Chinglyn/SDP-2A/README.md

# SDP-2A电控板
PCB板号CLR.DB01.A
PCBA料号：21.03.01.27.00
功能：DS18B20检测温度、电机控制出片、加热器吹风控制等
