Chinglyn/SDP-2A/15 电控设计方案书/SDP-2A电控设计框图.docx

SDP-2A相关框图

1、 功能框图

功能框图主要说明SDP-2A包含哪些功能模块，以及相关功能模块之间的关系。

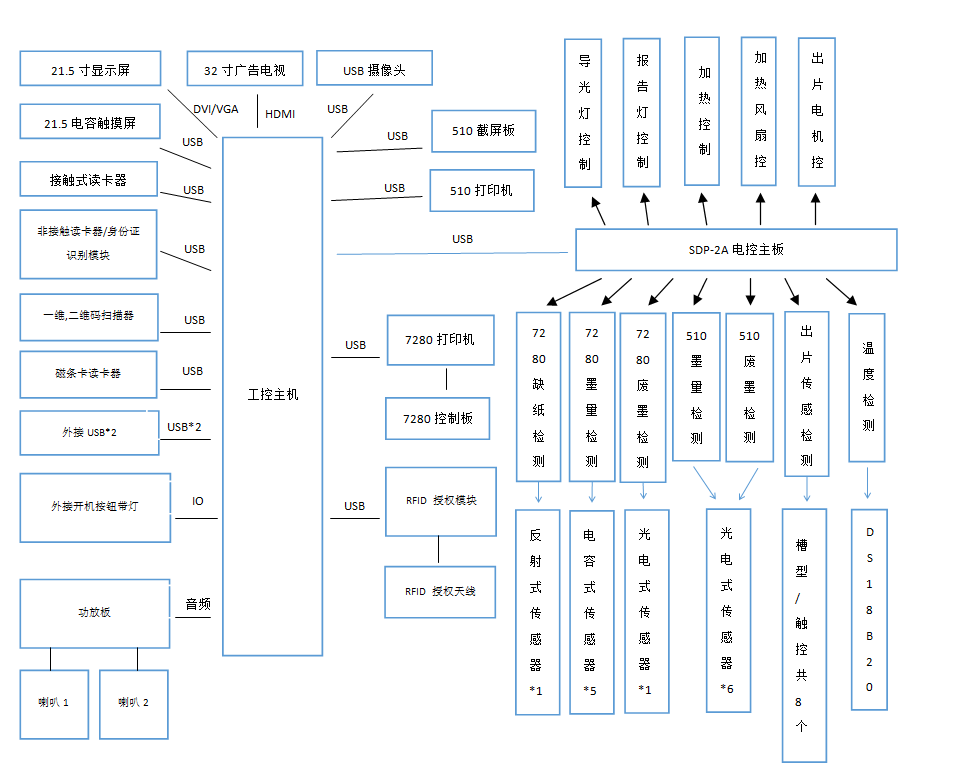
[picture p17: figure]
SDP-2A功能框图

2、 电气框图

电气框图主要说明SDP-2A 电气相关走向。

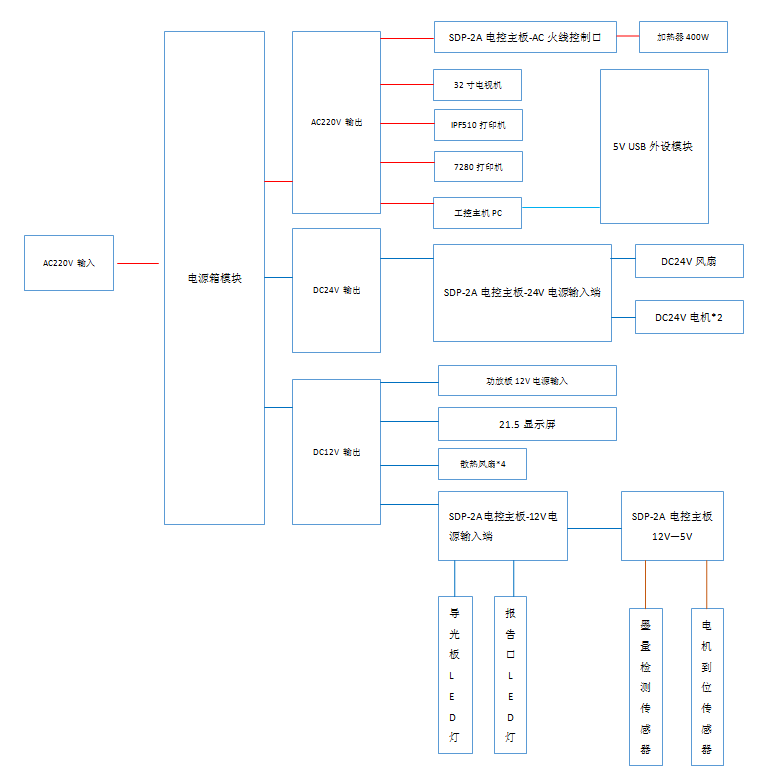
[picture p18: figure]
SDP-2A 电气结构框图
