Chinglyn/SDP-2A/10 BOM清单/CLR.DB01.A_BOM_V1.1_20171115.xlsx

Sheet: 变更
变更描述： 1. CLR.DB03.A, kb A级，尺寸:55*55(mm),板厚1.6mm,FR4，双面板,无铅,蓝油，沉金 描述错误，更改为CLR.DB01.A, kb A级，尺寸:140*110(mm),板厚1.6mm,FR4，双面板,无铅,蓝油，沉金
日期 | 2017-11-15

Sheet: BOM表
序号 | 物料编码 | 图纸番号 | 版本号 | 名称 | 规格参数 | 封装 | 数量 | 单位 | 位号 | 工艺 | 替代型号 | 注释 | 指定供应厂商（代理） | 联系人 | 联系方式
1 |  |  |  | PCB | CLR.DB01.A, kb A级，尺寸:140*110(mm),板厚1.6mm,FR4，双面板,无铅,蓝油，沉金 | / | 1 | PCS
2 |  |  |  | 贴片电容 | X5R,0.1uF±10%,50V,0805 | 0805 | 35 | PCS | C1,C6,C7 C9,C10,C11,C13,C14 C16,C17,C18,C19,C20,C21,C22,C23,C25,C27,C28,C29,C30,C31,C32,C33,C44,C46,C48,C52 C55,C57,C61,C62,C63,C82,C90 | SMT |  | 0.1uF=100nF
3 |  |  |  | 贴片电容 | X5R,1000pF±10%,50V,0805 | 0805 | 7 | PCS | C37,C38,C39,C40,C41,C42,C93 | SMT |  | 1000pF=1nF
4 |  |  |  | 贴片电容 | X5R,10uF±10%,50V,0805 | 0805 | 9 | PCS | C8,C12,C15,C24,C26,C51,C56,C58,C85 | SMT
5 |  |  |  | 贴片电容 | X5R,22pF±10%,16V,0805 | 0805 | 4 | PCS | C4,C5,C43,C45 | SMT
6 |  |  |  | 贴片电容 | X5R,10uF±10%,16V,0805 | 0805 | 3 | PCS | C35,C36,C49 | SMT
7 |  |  |  | 贴片二极管 | 1N5819,DO-214AC | DO-214AC | 8 | PCS | D2,D3,D4,D5,D6,D8,D10,D12 | SMT
8 |  |  |  | 贴片功率电感 | GDH74–6R8N 6.8uH | INDB700X700N | 1 | PCS | L4 | SMT
9 |  |  |  | 贴片LED | 贴片LED SMD 型号：1206-1-BC VF:1.9-2.1V 蓝色 | 0805 | 4 | PCS | D1,D7,D9,D11 | SMT
10 |  |  |  | 贴片共模电感 | ACM2012-900-2P,0805 | 0805 | 1 | PCS | FB8 | SMT
11 |  |  |  | 贴片MOS管 | 贴片MOS管,IRF540S,N沟道MOS管,SOT404 (D2PAK) | SOT404 | 1 | PCS | Q3 | SMT
12 |  |  |  | 贴片MOS管 | BLM3400,N沟道MOSFET,Vds=30V,Id=5.8A,SOT23 | SOT23 | 5 | PCS | Q1,Q2,Q4,Q5,Q6 | SMT | AO3400A
13 |  |  |  | 贴片光耦 | TLP181GB,SOP4 | SOP4 | 2 | PCS | U2,U3 | SMT
14 |  |  |  | 贴片电阻 | 100K±5%,1/8W,0805 | 0805 | 2 | PCS | R121,R132 | SMT
15 |  |  |  | 贴片电阻 | 2K±5%,1/8W,0805 | 0805 | 9 | PCS | R3,R6,R15,R59,R64,R72,R76,R97,R113 | SMT
16 |  |  |  | 贴片电阻 | 44.2K±1%,1/8W,0805 | 0805 | 1 | PCS | R124 | SMT
17 |  |  |  | 贴片电阻 | 0R±5%,1/8W,0805 | 0805 | 23 | PCS | R7,R10,R16,R19,R36,R54,R57,R58,R60,R65,R68 R77,R78,R85,R89,R93,R98,R99,R114,R128,R129，R130,R131 | SMT
18 |  |  |  | 贴片电阻 | 0.3Ω±1%,1W,2512 | 2512 | 2 | PCS | R24,R25 | SMT
19 |  |  |  | 贴片电阻 | 10K±5%,1/8W,0805 | 0805 | 15 | PCS | R26，R31,R33,R34,R53,R56,R67,R71,R75,R84,R87,R88 ,R91,R100,R123 | SMT
20 |  |  |  | 贴片电阻 | 1K±5%,1/8W,0805 | 0805 | 29 | PCS | R4,R11,R12,R18, R21，R23,R29,R39,R43,R47,R51,R55,R62,R70,R74,R81,R82,R83,R86,R90,R95,R101,R105,R109,R111,R116,R117,R119,R120 | SMT
21 |  |  |  | 贴片电阻 | 200Ω±5%,1/8W,0805 | 0805 | 2 | PCS | R35，R28 | SMT
22 |  |  |  | 贴片电阻 | 300Ω±5%,1/8W,0805 | 0805 | 8 | PCS | R22,R30,R40,R44,R48,R52,R102,R106 | SMT
23 |  |  |  | 贴片电阻 | 390Ω±5%,1/8W,0805 | 0805 | 9 | PCS | R2,R5,R13,R20,R63,R69,R73,R96,R112 | SMT
24 |  |  |  | 贴片电阻 | 4.7K±5%,1/8W,0805 | 0805 | 14 | PCS | R1,R9,R14,R32,R37,R41,R45,R49,R79, R103,R107,R118,R122 | SMT
25 | 21.04.000200 |  |  | 贴片IC | A4954ELP-T,TSSOP16 | TSSOP16 | 1 | PCS | U7 | SMT |  |  | 由柯丽尔提供
26 | 21.04.001000 |  |  | 贴片IC | STC15W4K32S4,LQFP48 | LQFP48 | 1 | PCS | U5 | SMT |  | 需烧录固件 | 由柯丽尔提供
27 | 21.04.000400 |  |  | 贴片IC | CH340G,SOP16 | SOP16 | 1 | PCS | U11 | SMT |  |  | 由柯丽尔提供
28 | 21.04.001100 |  |  | 贴片IC | ZTP7193SI,SOP8 | SOP8 | 1 | PCS | U10 | SMT |  |  | 由柯丽尔提供
29 |  |  |  | 贴片ESD | WE05R,SOT143 | SOT143 | 1 | PCS | U6 | SMT
30 |  |  |  | 贴片晶振 | 11.0592MHz,±20PPM,CL=22pF,HC-49SMD | HC-49SMD | 1 | PCS | Y1 | SMT
31 |  |  |  | 贴片晶振 | 12MHz,±20PPM,CL=22pF,HC-49SMD | HC-49SMD | 1 | PCS | Y2 | SMT
32 |  |  |  | XH连接器 | XH 2.54mm-4P 电流 6A 直插 | XH2.54_4P | 1 | PCS | J34 | DIP
33 |  |  |  | 直插电解电容 | 220uF±20%,50V,10mm*12mm | 10mm*12mm | 2 | PCS | C47,C81 | DIP
34 |  |  |  | 直插电解电容 | 470uF±20%,10V,6mm*12mm | CE/8MM | 2 | PCS | C2,C34 | DIP
35 |  |  |  | 插件蜂鸣器 | 5V,有源电磁式,直径12mm*高9.5mm,引脚间距7.6mm | BEEP | 1 | PCS | BEEP | DIP
36 |  |  |  | AMP连接器 | AMP-292132-3,2.0mm-3P | PH-3P-2.0 | 7 | PCS | J17,J18,J19,J20,J21,J22 J27 | DIP
37 |  |  |  | PH连接器 | PH2.0mm-3P | PH-3P-2.0 | 8 | PCS | J1,J5 J7,J8,J9,J11,J29,J33 | DIP
38 |  |  |  | CH连接器 | CH3.96mm-2P | CH3.96_2P_2 | 2 | PCS | J23,J25 | DIP
39 |  |  |  | 绿色边沿连接器 | Edg 5.08mm-2P-90 90度 | SIP-2-5.08 | 1 | PCS | J24 | DIP
40 |  |  |  | VH连接器 | VH 3.96mm-2P 带扣 直插 | CH_3.96-2P | 1 | PCS | J32 | DIP
41 |  |  |  | XH连接器 | XH 2.54mm-2P 电流 6A 直插 | XH-2.54-2P | 3 | PCS | J26,J30,J31 | DIP
42 |  |  |  | 排针 | 2.54mm，2P，9mm高 | SIP-2P | 1 | PCS | J28 | DIP
43 |  |  |  | 跳线帽 | 2.54mm,2P | / | 1 | PCS | J28 | DIP |  | 插在排针上
44 |  |  |  | PH连接器 | PH 2.0mm-5p 直插 | PH-5P-2.0 | 1 | PCS | J3 | DIP
45 |  |  |  | XH连接器 | XH 2.54mm-3P 直插 | XH-2.54-3P | 7 | PCS | J4,J10,J12,J13,J14,J15,J16 | DIP
46 |  |  |  | / | NC | / | 20 | PCS | D13,Q7,R8,R17,R27,R38,R42,R46,R50,R61,R66,R80,R92,R94 ,R104,R108,R110,R115,R126,R127 |  |  | 不贴
