Chinglyn/SDP-2A/04 PCB制作表/PCB制作表CLR.DB01.A.xls

深圳市巨鼎医疗设备有限公司
CLR.DB01.A加工工艺要求
 |  |  |  |  | 填表日期：2016 年11月18日
厂商资料 | 1.厂商名称 |  |  | 5.E-mail/FTP
 | 2.联系人 |  |  | 6.厂商料号
 | 3.TEL |  |  | 7.预计完成日
 | 4.FAX |  |  | 8.交货数量
资料内容 | 1.档案名称 | CLR.DB07.A gerber.rar
 | 2.料号
 | 3.版本号 | V1.0
 | 4.档案格式 | ■ GERBER □ PCB □其他
 | 5.书面资料 | □ 无 ■ 有
 | 6.线路层 | □ 无 ■ 有
 | 7.孔径孔位图 | □ 无 ■ 有
 | 8.阻焊层 | □ 无 ■ 有
 | 9.丝印层 | □ 无 ■ 有
 | 10.机械图 | □ 无 ■ 有
 | 11.拼板方式 | 无
制作要求 | 1.基板材料 | ■ FR4 □ CEM □ 其他
 | 2.阻燃级别 | ■ 94V0 □ 其他
 | 3.铜箔厚度 | □ 1/2OZ ■ 1OZ □ 1.5OZ □ 2OZ □ 其他:
 | 4.钻孔方式 | ■ 机械钻 □ 激光钻
 | 5.最大尺寸 | 单板 110mm*140mm
 | 6.成品厚度 | □ 1.0mm □ 1.2mm ■ 1.6mm □ 2.0mm □ 其他
 | 7.基板层数 | ■ 2L □ 4L □ 6 □ 8L □ 其他
 | 8.表面处理 | ■ 化学沉金 □ 全板镀金 □ 化学浸镍 □ 其他:BGA OSP
 | 9.阻焊 | □ 单面 ■ 双面 ■ 其他:蓝油
 | 10.丝印 | □ 单面 ■ 双面 ■ 其他:白油
 |  | UL Logo: | □ 有 ■ 无 | 加于 层
 | 11.外型加工 | □ 模具冲 □ 铣 ■ V-CUT
 |  |  | V-CUT规格：角度 | 深度 | 残厚
 | 12.埋盲孔 | 层 至 层 层至 层 层至 层 层至 层
 | 13.塞孔 | ■ 是 □ 否 (需要赛孔)
 | 14.特性阻抗 | 层，线宽 ，规格 ±Ω，其他：
 | 15. 其他 | 在能满足正常贴焊要求的前提下，PCB所含镍的成分越少越好！
备注 | 以上如果有疑问，请进行书面确认。
 | 工程问题联系人： |  | 张斌 | Email： | zhangbin@rdcofclear.com
 | 电话： |  | 13427559902
