Chinglyn/SDP-2A/08 PCBA板接口说明/SDP-2A CLR.DB01.A 电控装机说明.xls

SDP-2A 电控板CLR.DB01.A 接口说明
序号 | 名称 | PCBA接口 | 接线规格 | 颜色 | 供电电压 | 控制方式/说明 | 状态说明 | 规格 | 端口方向 | 数量 | 备注
1 | 起始切刀 出片通道传感器P0 | J27 | AMP TYCO连接器 173977-3 接头 AWG26 | 红 白 黑 | DC5V | IO采集 P5.4 | 切胶片过程为低，切完归位为高 |  | 上拉输入 | 1
2 | 结束切刀 出片通道传感器P1 | J22 | AMP TYCO连接器 173977-3 接头 AWG26 | 红 白 黑 | DC5V | IO采集 P0.4 | 切胶片过程为低，切刀挡住为高，切刀归位为低 |  | 上拉输入 | 1
3 | 胶片入口 出片通道传感器P2 | J21 | AMP TYCO连接器 173977-3 接头 AWG26 | 红 白 黑 | DC5V | IO采集 P0.3 | 有胶片进入为低，无胶片为高 |  | 上拉输入 | 1
4 | 离合关 出片通道传感器P3 | J20 | AMP TYCO连接器 173977-3 接头 AWG26 | 红 白 黑 | DC5V | IO采集 P0.2 | 检测为低，表示离合开位置 |  | 上拉输入 | 1
5 | 离合开 出片通道传感器P4 | J19 | AMP TYCO连接器 173977-3 接头 AWG26 | 红 白 黑 | DC5V | IO采集 P0.1 | 检测为低，表示离合开位置 |  | 上拉输入 | 1
6 | 胶片出口 出片通道传感器P5 | J18 | AMP TYCO连接器 173977-3 接头 AWG26 | 红 白 黑 | DC5V | IO采集 P0.0 | 有胶片进入为低，无胶片为高 |  | 上拉输入 | 1
7 | 计数传感器 出片通道传感器P6 | J17 | AMP TYCO连接器 173977-3 接头 AWG26 | 红 白 黑 | DC5V | IO采集 P4.6 | 挡住为高，没挡住为敌 |  | 上拉输入 | 1
8 | 7208缺纸传感器 | J33 | PH 2.0mm-3P 母壳 AWG26 | 红 白 黑 | DC5V | IO采集 P4.5 | 有纸张为高，无纸张为低 |  | 上拉输入 | 1
9 | 温度传感器 | J29 | PH 2.0mm-3P 母壳 AWG26 | 红 黄 黑 | DC5V | IO单总线 P2.6 | 单总线，无通信时为高电平 |  | 输入输出 | 1
 | 预留接口 | J1 | PH 2.0mm-3P 母壳 AWG26 |  |  | IO采集 P2.5 |  |  | 输入输出 | 1 | 不接 预留
10 | PC USB通信线 | J3 | USB2.0----PH 2.0mm-5P | 红白绿黑 黑 | DC5V | USB |  |  | 输入输出 | 1
11 | IPF510墨桶 传感器 1# | J4 | XH 2.54mm-3P 母壳 | 传感器带线 | DC5V | IO采集 P0.5 | 接传感器时：有墨为低，无墨为高，不接传感器为低 |  | 下拉输入 | 1
12 | IPF510墨桶 传感器 2# | J10 | XH 2.54mm-4P 母壳 | 传感器带线 | DC5V | IO采集 P0.6 | 接传感器时：有墨为低，无墨为高，不接传感器为低 |  | 下拉输入 | 1
13 | IPF510墨桶 传感器 3# | J12 | XH 2.54mm-5P 母壳 | 传感器带线 | DC5V | IO采集 P0.7 | 接传感器时：有墨为低，无墨为高，不接传感器为低 |  | 下拉输入 | 1
14 | IPF510墨桶 传感器 4# | J13 | XH 2.54mm-6P 母壳 | 传感器带线 | DC5V | IO采集 P1.0 | 接传感器时：有墨为低，无墨为高，不接传感器为低 |  | 下拉输入 | 1
15 | IPF510墨桶 传感器 5# | J14 | XH 2.54mm-7P 母壳 | 传感器带线 | DC5V | IO采集 P1.1 | 接传感器时：有墨为低，无墨为高，不接传感器为低 |  | 下拉输入 | 1
16 | IPF510 废墨 传感器 | J15 | XH 2.54mm-7P 母壳 | 传感器带线 | DC5V | IO采集 P3.4 | 接传感器时：有墨为低，无墨为高，不接传感器为低 |  | 下拉输入 | 1
17 | 7280 废墨 传感器 | J16 | XH 2.54mm-7P 母壳 | 传感器带线 | DC5V | IO采集 P3.3 | 接传感器时：有墨为低，无墨为高，不接传感器为低 |  | 下拉输入 | 1
18 | 7280 墨盒检测传感器C | J9 | PH 2.0mm-3P 母壳 | 传感器带线 | DC5V | IO采集 P4.7 | 接传感器时：有墨为低，无墨为高，不接传感器为高 |  | 上拉输入 | 1
19 | 7281 墨盒检测传感器M | J5 | PH 2.0mm-3P 母壳 | 传感器带线 | DC5V | IO采集 P1.2 | 接传感器时：有墨为低，无墨为高，不接传感器为高 |  | 上拉输入 | 1
20 | 7282 墨盒检测传感器Y | J7 | PH 2.0mm-4P 母壳 | 传感器带线 | DC5V | IO采集 P1.3 | 接传感器时：有墨为低，无墨为高，不接传感器为高 |  | 上拉输入 | 1
21 | 7283 墨盒检测传感器BK | J8 | PH 2.0mm-5P 母壳 | 传感器带线 | DC5V | IO采集 P1.4 | 接传感器时：有墨为低，无墨为高，不接传感器为高 |  | 上拉输入 | 1
22 | 7284 墨盒检测传感器MBK | J11 | PH 2.0mm-6P 母壳 | 传感器带线 | DC5V | IO采集 P1.5 | 接传感器时：有墨为低，无墨为高，不接传感器为高 |  | 上拉输入 | 1
23 | DC24V 输入接口 | J25 | CH3.96mm-2P AWG20 | 红 黑 | DC24V | 电源输入 |  |  | / | 1
24 | 直流电机驱动输出接口 | J34 | XH2.54mm -4P AWG20 | 红 黑（离合） 红黑（送片） | DC24V | 控制输出 |  |  | / | 1
25 | DC24V 横流 加热风扇控制接口 | J23 | VH3.96mm-4P AWG20 带扣 | 红 黑 黄 棕 | DC24V | 控制输出 | IO:低电平开加热风扇 |  | / | 1
26 | 加热器控制接口 | J24 | CH3.96mm-2P AWG20 | 红 黑 | DC12V | 控制输出 | IO:低电平开加热器 |  | / | 1
27 | 预留心跳控制接口 | J31 | XH2.54mm -2P AWG20 | 红 黑 | DC12V | 控制输出 | IO:高电平开灯，低电平关灯 |  | / | 1 | 不接 预留
28 | 导光灯控制接口 | J26 | XH2.54mm -2P AWG20 | 红 黑 | DC12V | 控制输出 | IO:高电平开灯，低电平关灯 |  | / | 1
29 | 兄弟打印机出纸通道电机控制口 | J30 | XH2.54mm -2P AWG20 | 红 黑 | DC12V | 控制输出 | IO:高电平电机转 |  | / | 1 | 不接 预留
 |  |  |  |  |  |  |  |  | / | 1
30 | DC12V 电源输入接口 | J32 | VH3.96mm -2P AWG20 带扣 | 红 黑 | DC12V | 控制输出 | 电源输入接口 |  | / | 1
