Chinglyn/SDP-2A/(list of files, cad)

Other CAD files:
14 源程序工程/CLR.DB01.A_SDP-2A-V1.0 源程序工程/main.OBJ
14 源程序工程/CLR.DB01.A_SDP-2A-V1.0 源程序工程/harddrive.OBJ
14 源程序工程/CLR.DB01.A_SDP-2A-V1.0 源程序工程/STARTUP.OBJ
14 源程序工程/CLR.DB01.A_SDP-2A-V1.0 源程序工程/ds18b20.OBJ
14 源程序工程/CLR.DB01.A_SDP-2A-V1.0 源程序工程/comwithpc.OBJ
14 源程序工程/CLR.DB01.A_SDP-2A-V1.0 源程序工程/time.OBJ
14 源程序工程/CLR.DB01.A_SDP-2A-V1.0 源程序工程/moto.OBJ
14 源程序工程/CLR.DB01.A_SDP-2A-V1.0 源程序工程/uart1.OBJ
