Chinglyn/SDP-2A/12 原理图PDF文件/CLR.DB01.A.pdf

# MCU

# LED1

# LED2

# DS18B20_1

# Usb to uart

# 7280 墨量检测

# 510 墨量检测

# 510 废墨检测

7280废墨检测 | 烘干风扇

# 加热模块控制

# DC12V

# DC12V

# 温度传感器

# 烘干风扇 24V

# 继电器 控制AC220V

# 火线 L 通断

# 电容传感器

# 光电传感器

# 光电传感器

# 光电传感器

# 电源 DC12V--DC5V

# 直流电机 1

# 直流电机 2

5* IO

1* IO

1* IO

5* IO

# 2* IO PWM

# 2* IO PWM

1* IO

1* IO

1* IO

1* IO

# 1* IO uart1

槽型光电传感器 | 电机位置检测 | 8* IO

24V

电源 DC24V | 24V

# DS18B20_2 温度传感器 1* IO

12V·çÉÈ | 预留 1* IO
蜂鸣器 | 蜂鸣器 | 1* IO

# 开关电源

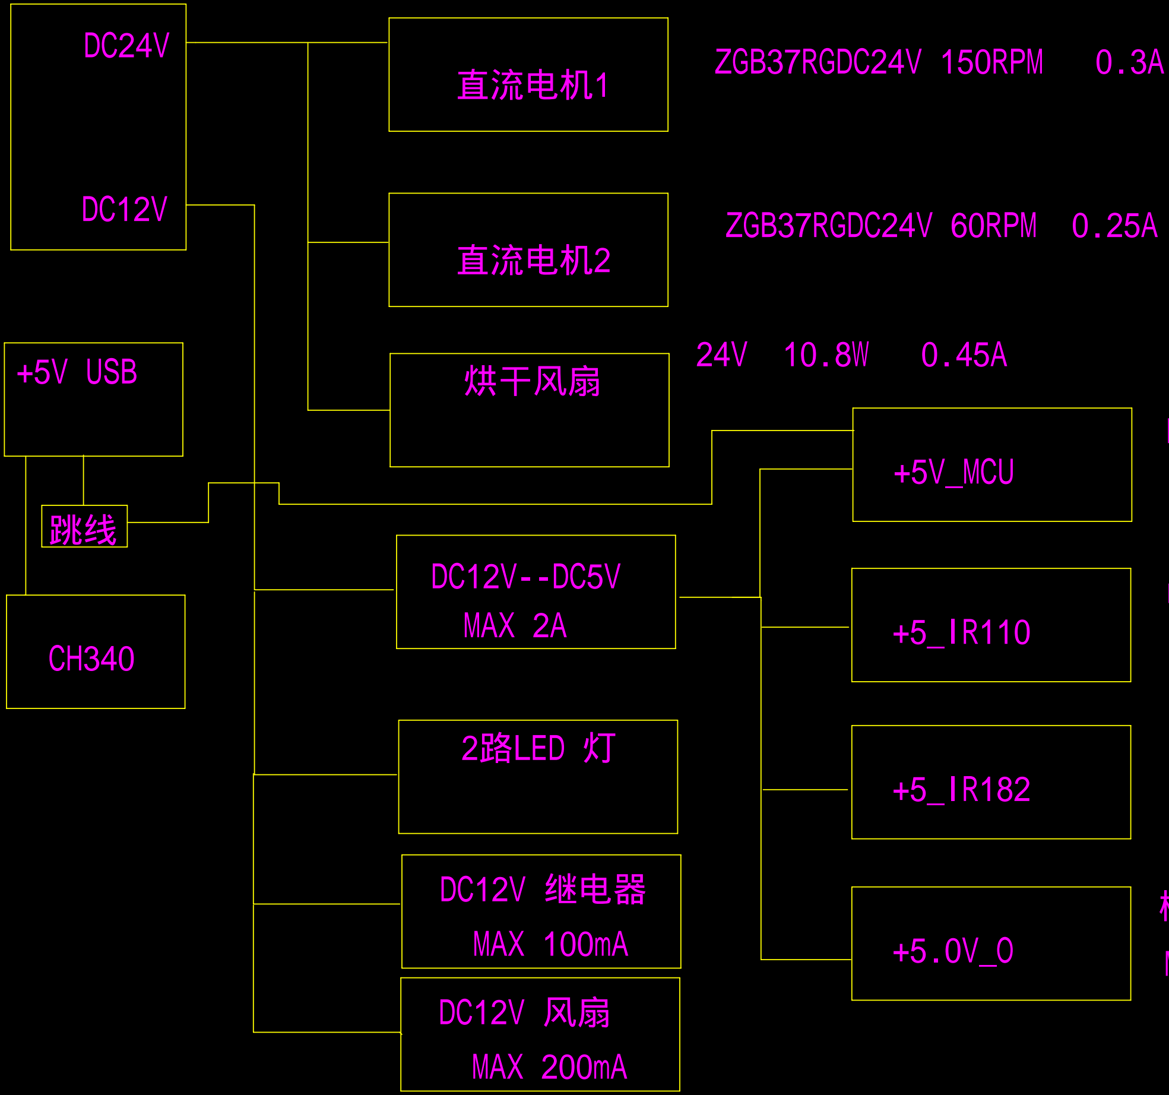
[picture p19: figure]
直流电机1; 直流电机2; 烘干风扇; 2路LED 灯; DC12V 继电器; +5V_MCU; ZGB37RGDC24V 150RPM; ZGB37RGDC24V 60RPM; MAX 2A; MAX 100mA; MAX 200mA; +5V USB

# 槽型传感器 -电机

# 光电传感器

# 电容传感器

# MCU

MAX | 200mA
MAX | 150mA
MAX | 200mA
MAX | 200mA

3A

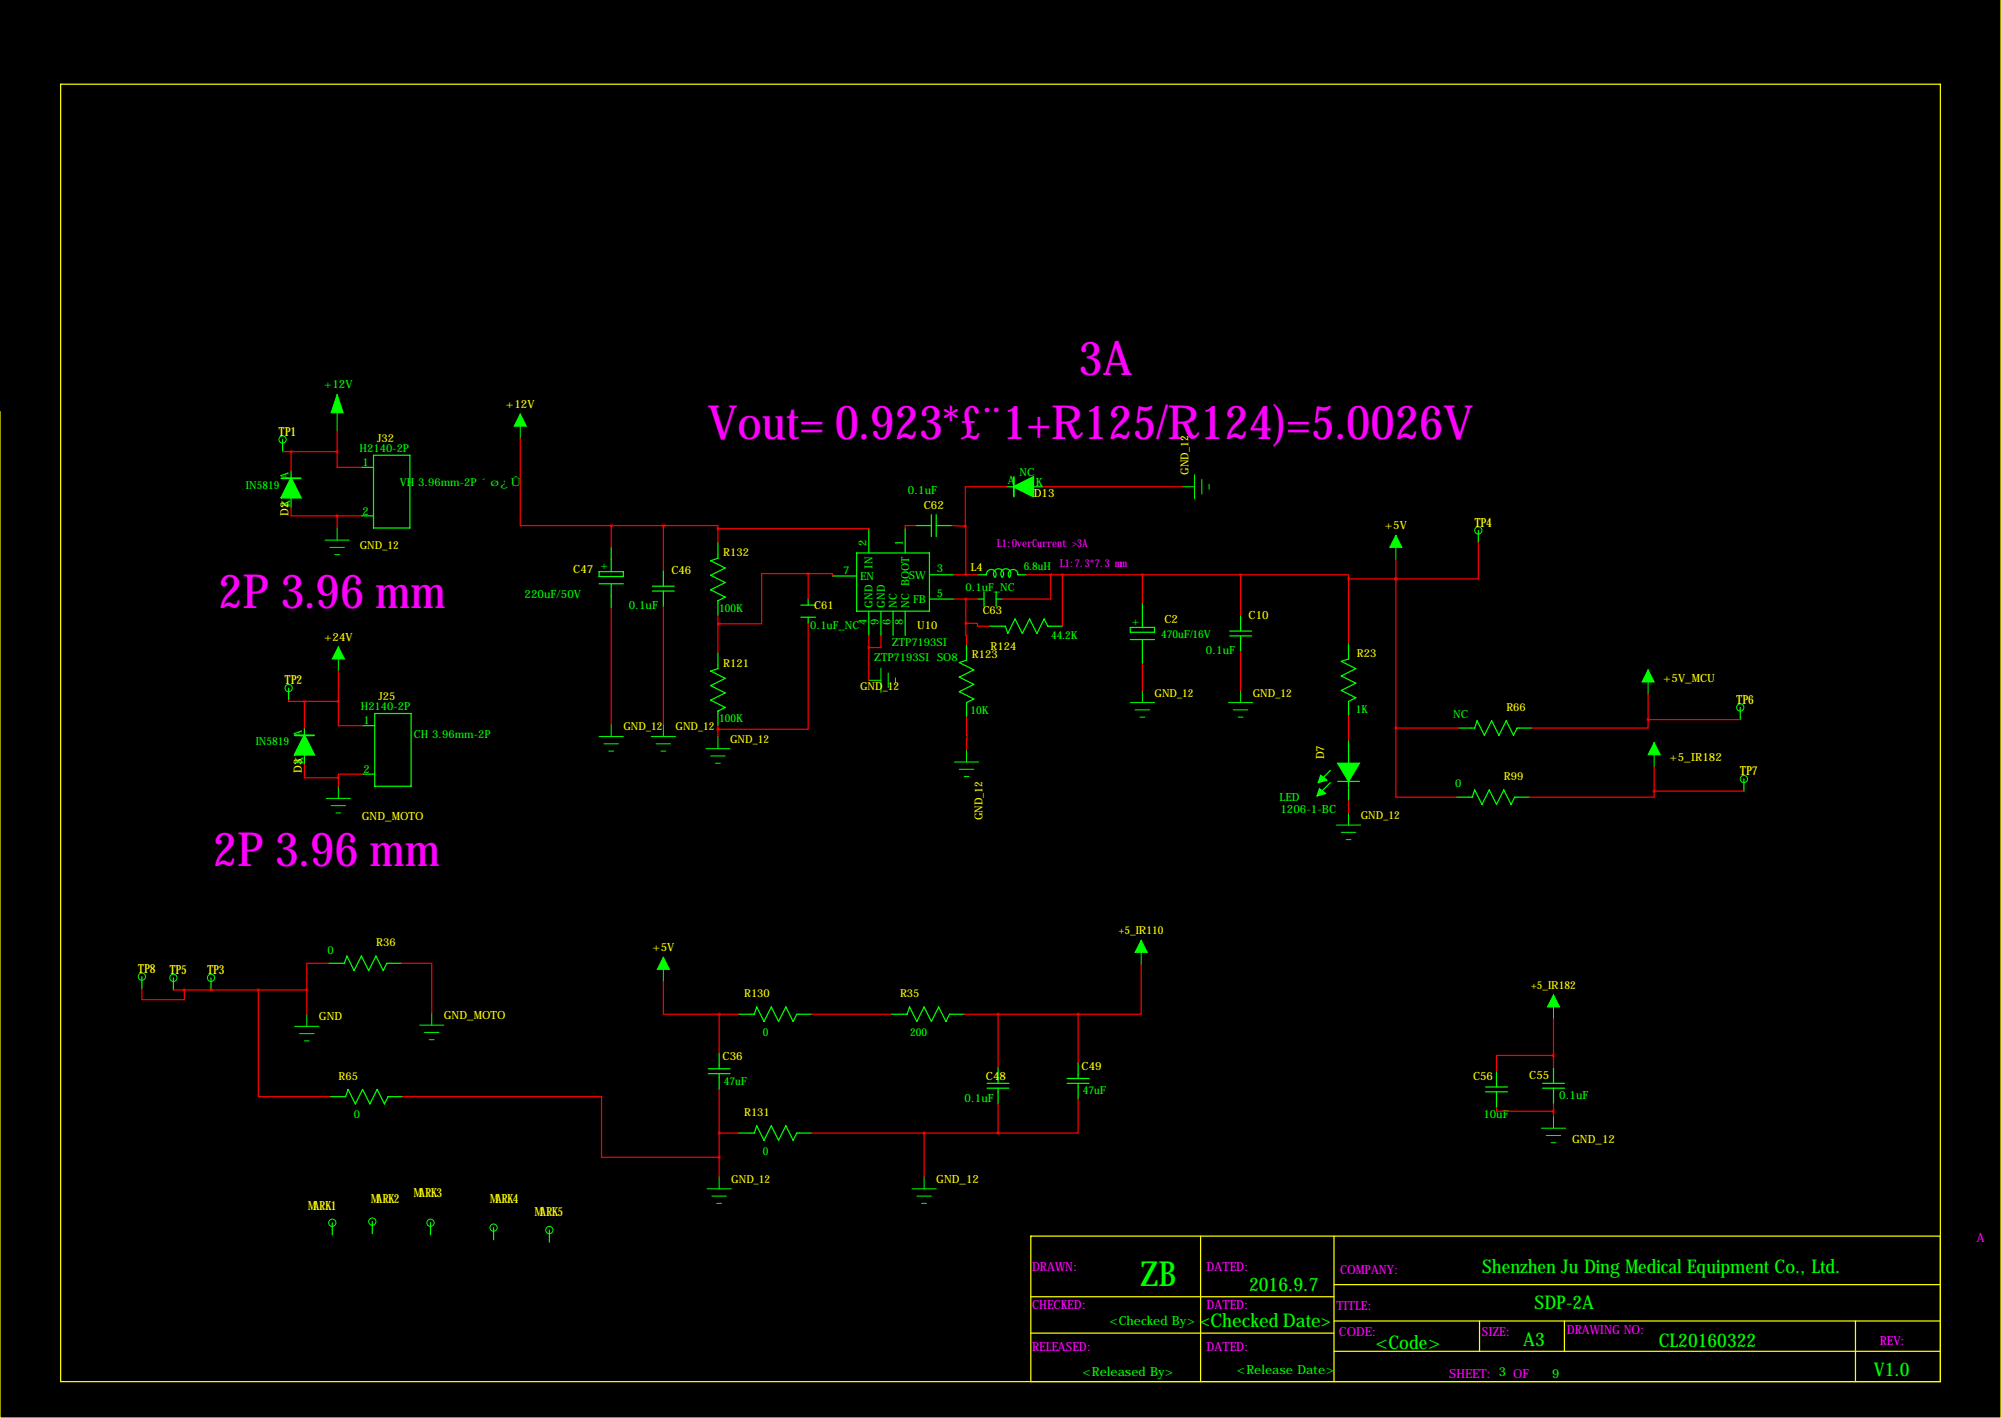
[picture p20: page 3]

Shenzhen Ju Ding Medical Equipment Co., Ltd.

CHECKED: <Checked By> | DATED: <Checked Date>

<Code> CODE: | SIZE: A3 | DRAWING NO: CL20160322 | REV:

RELEASED: <Released By> | DATED: <Release Date>

SHEET: OF | | | V1.0

# MCU

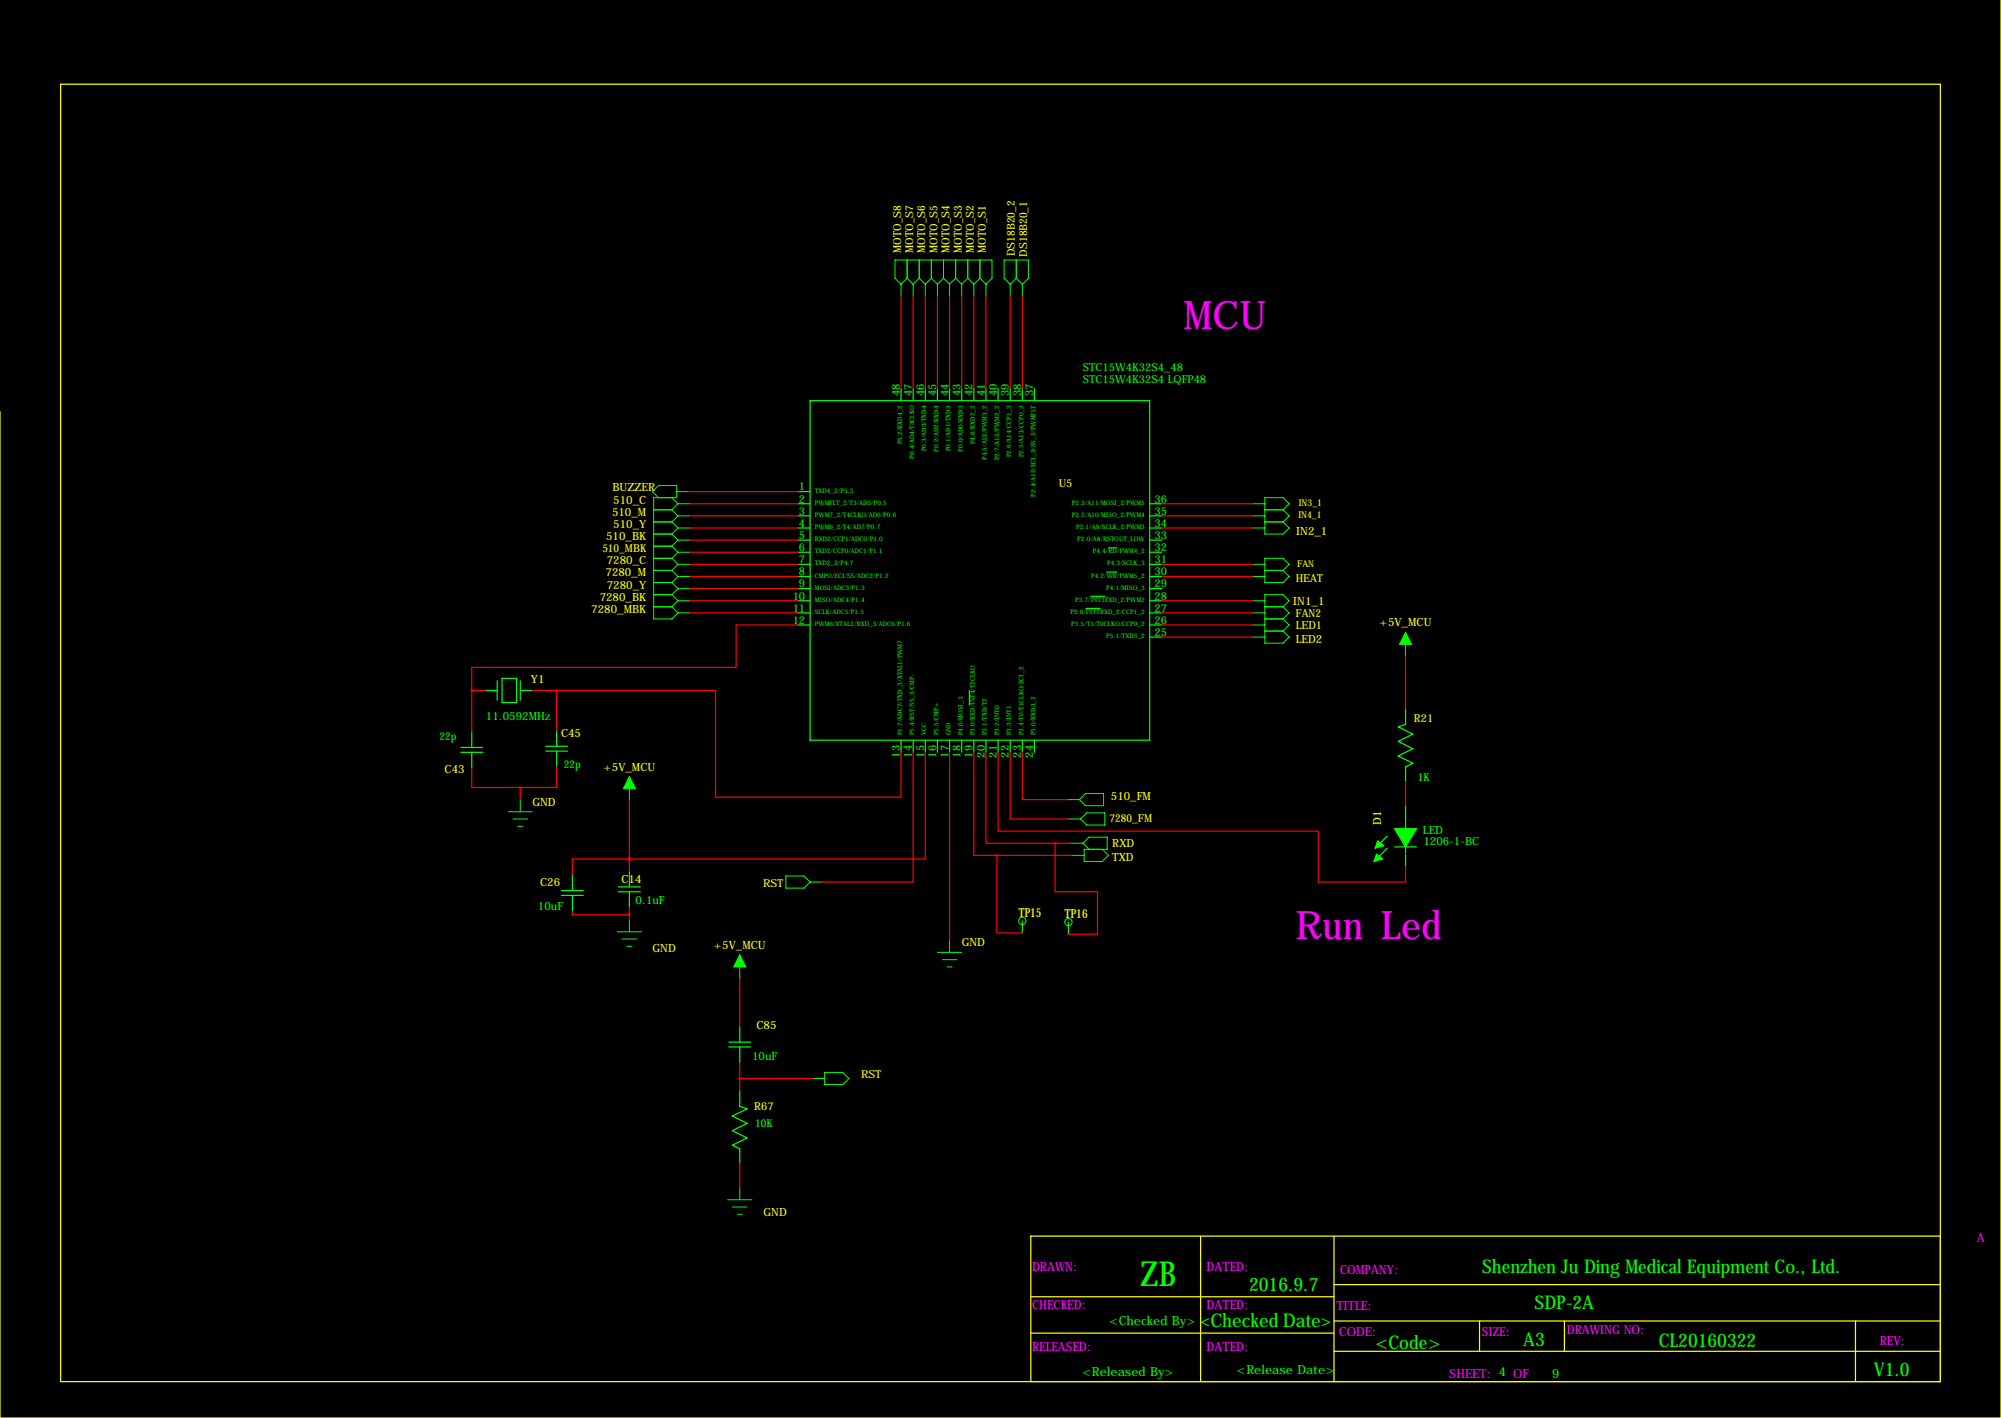
[picture p21: page 4]

Shenzhen Ju Ding Medical Equipment Co., Ltd.

DC1

# DC_Motor ZGB37RG DC24V MAX1.1A

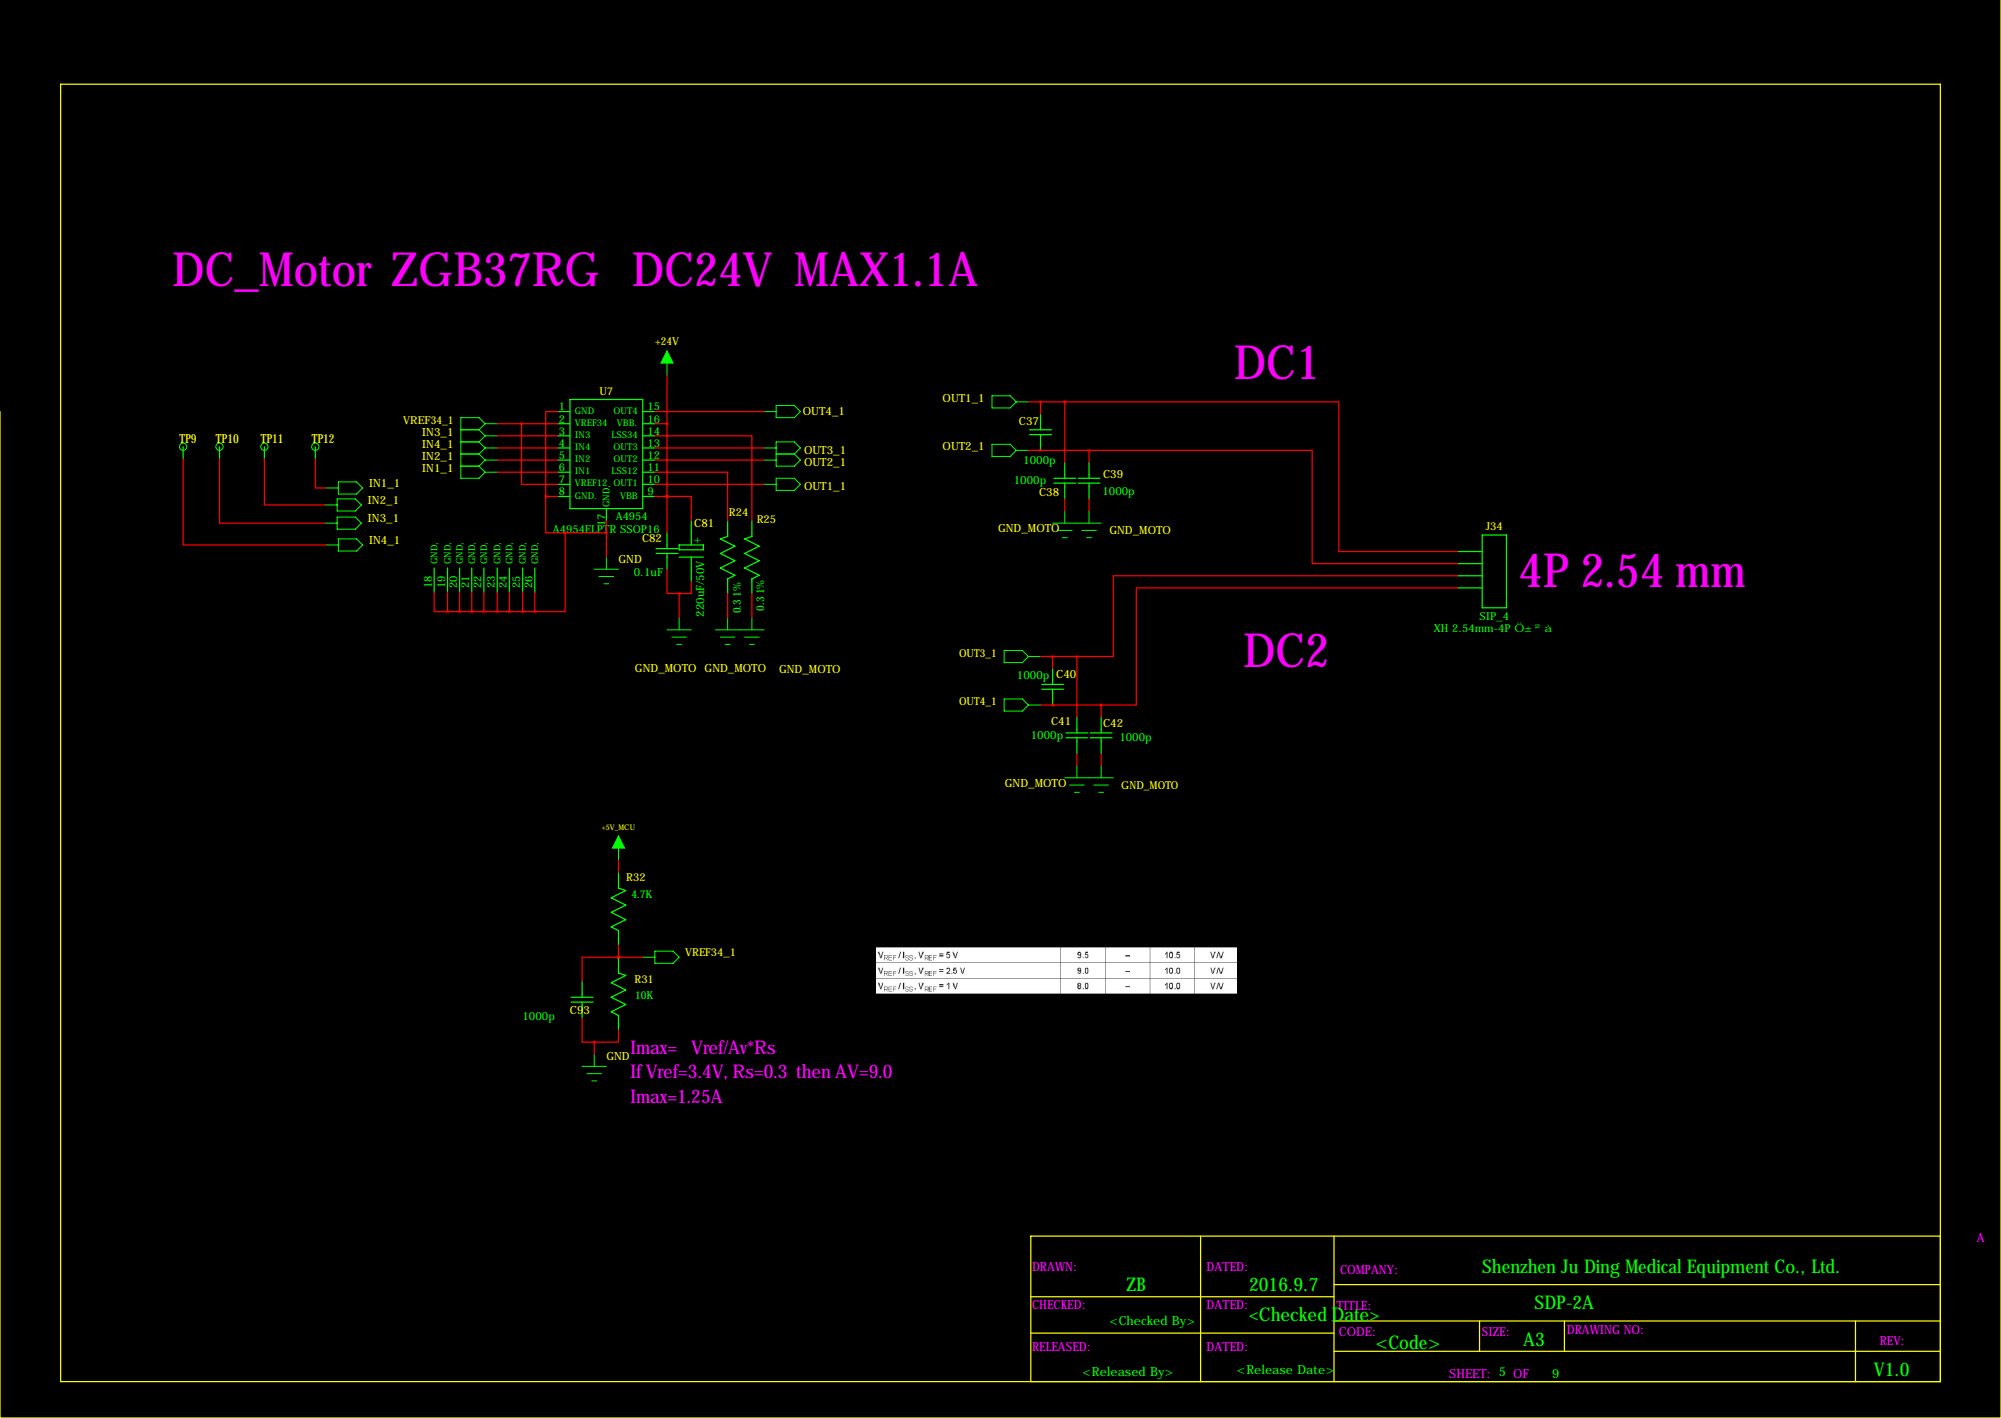
[picture p22: page 5]

18 GND, 19 GND, 20 GND, 21 GND, 22 GND, 23 GND, 24 GND, 25 GND, 26 GND,

Imax= Vref/Av*Rs
GND
If Vref=3.4V, Rs=0.3 then AV=9.0
Imax=1.25A

Shenzhen Ju Ding Medical Equipment Co., Ltd.

<Released By> | <Release Date>

# Sensor_5V Part

# 7280 FS-IR110-CA 3P 2.0 mm

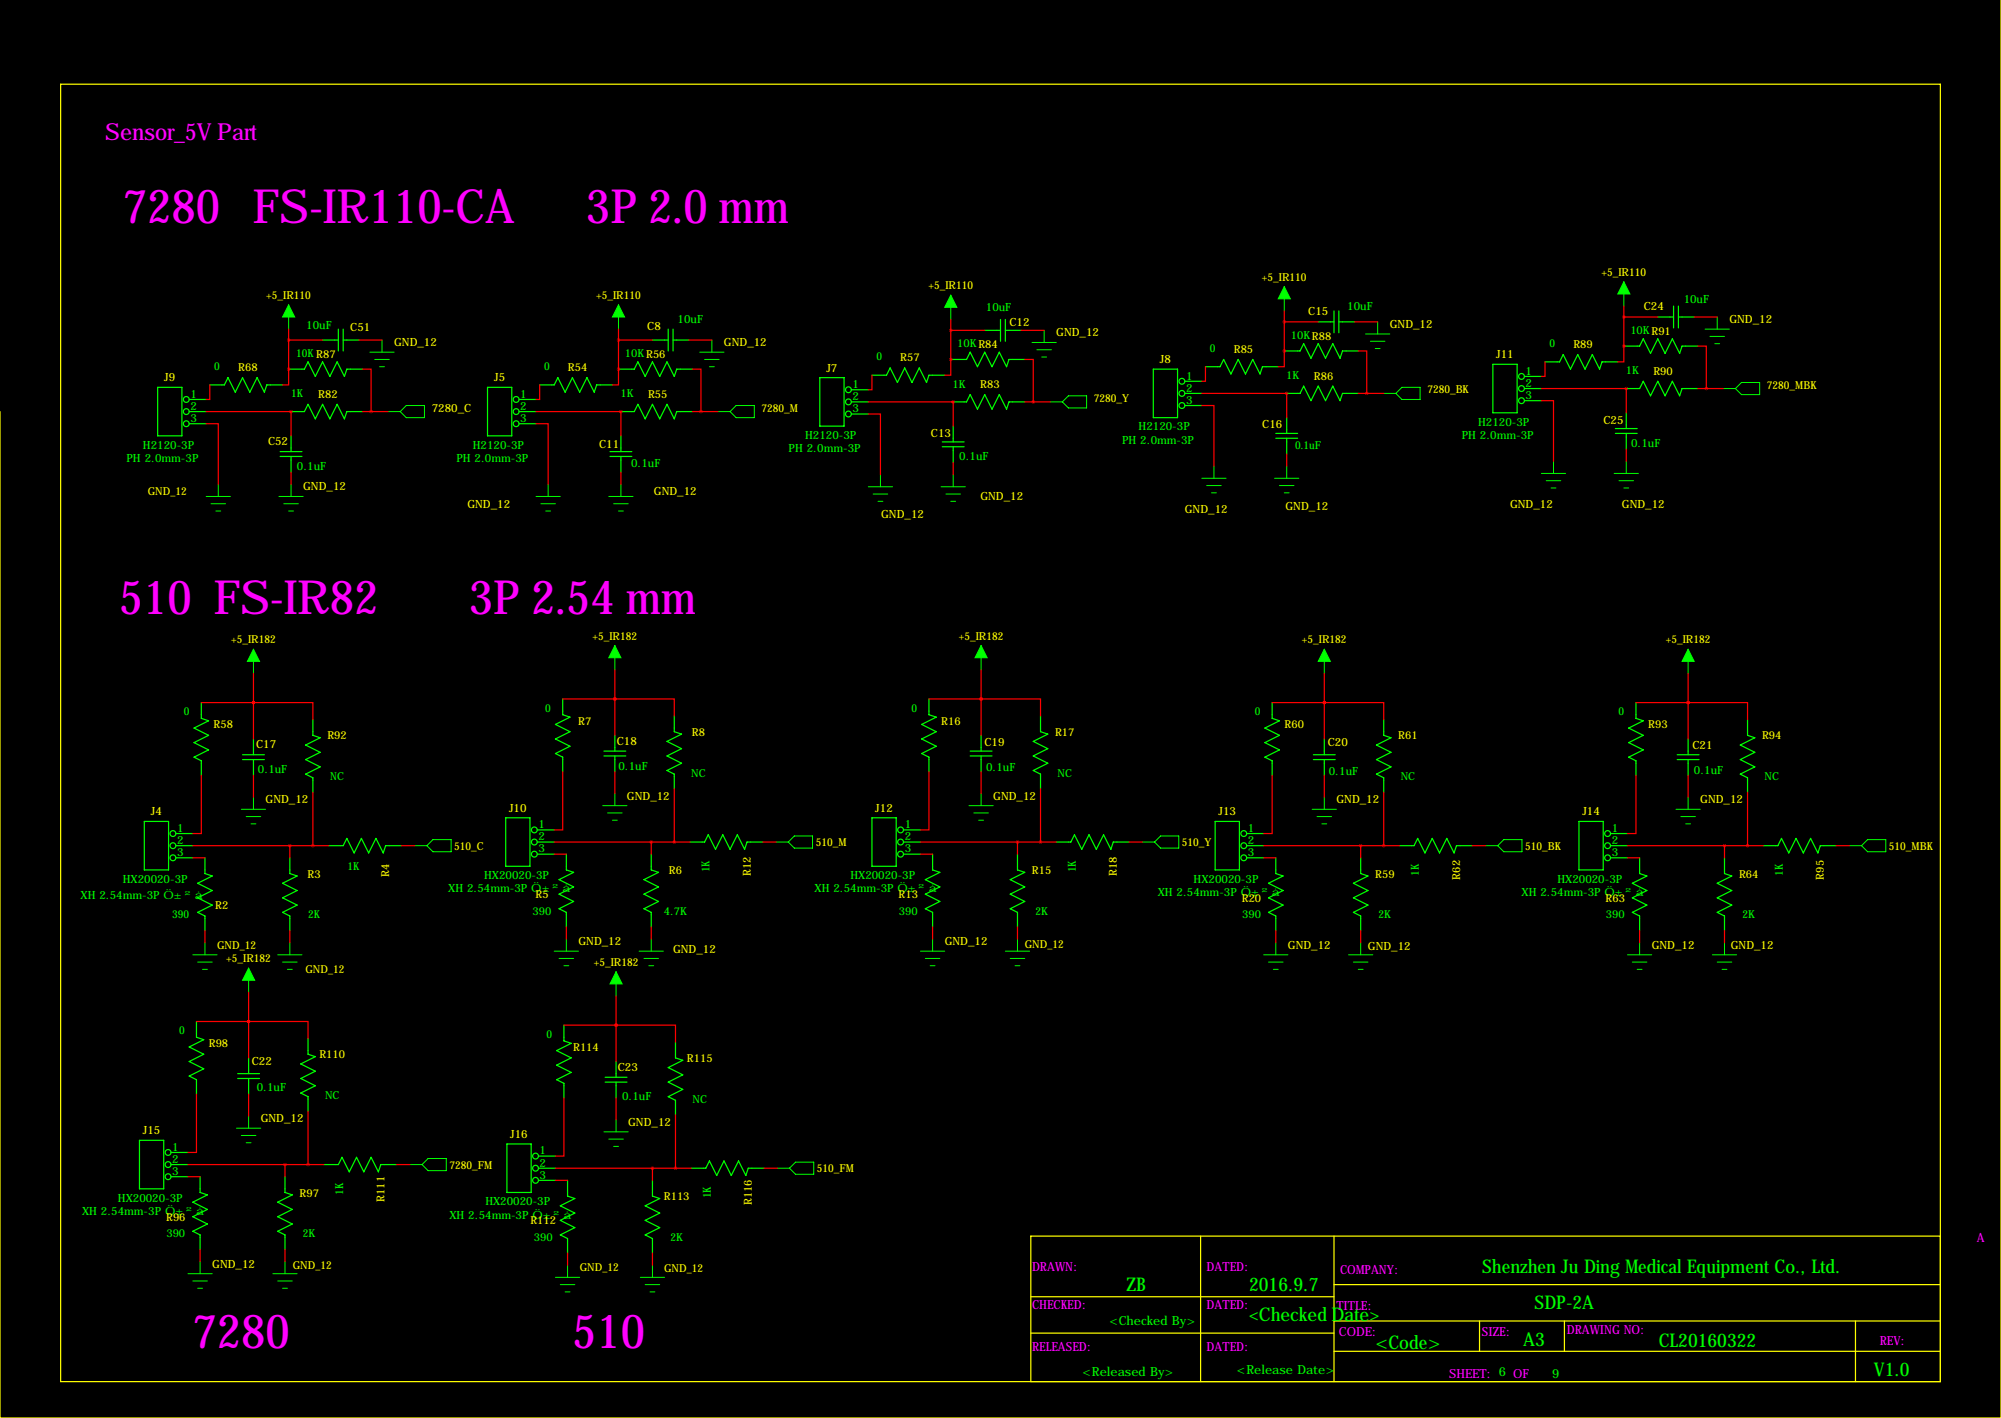
[picture p23: page 6]

Shenzhen Ju Ding Medical Equipment Co., Ltd.

<Released By> | <Release Date>

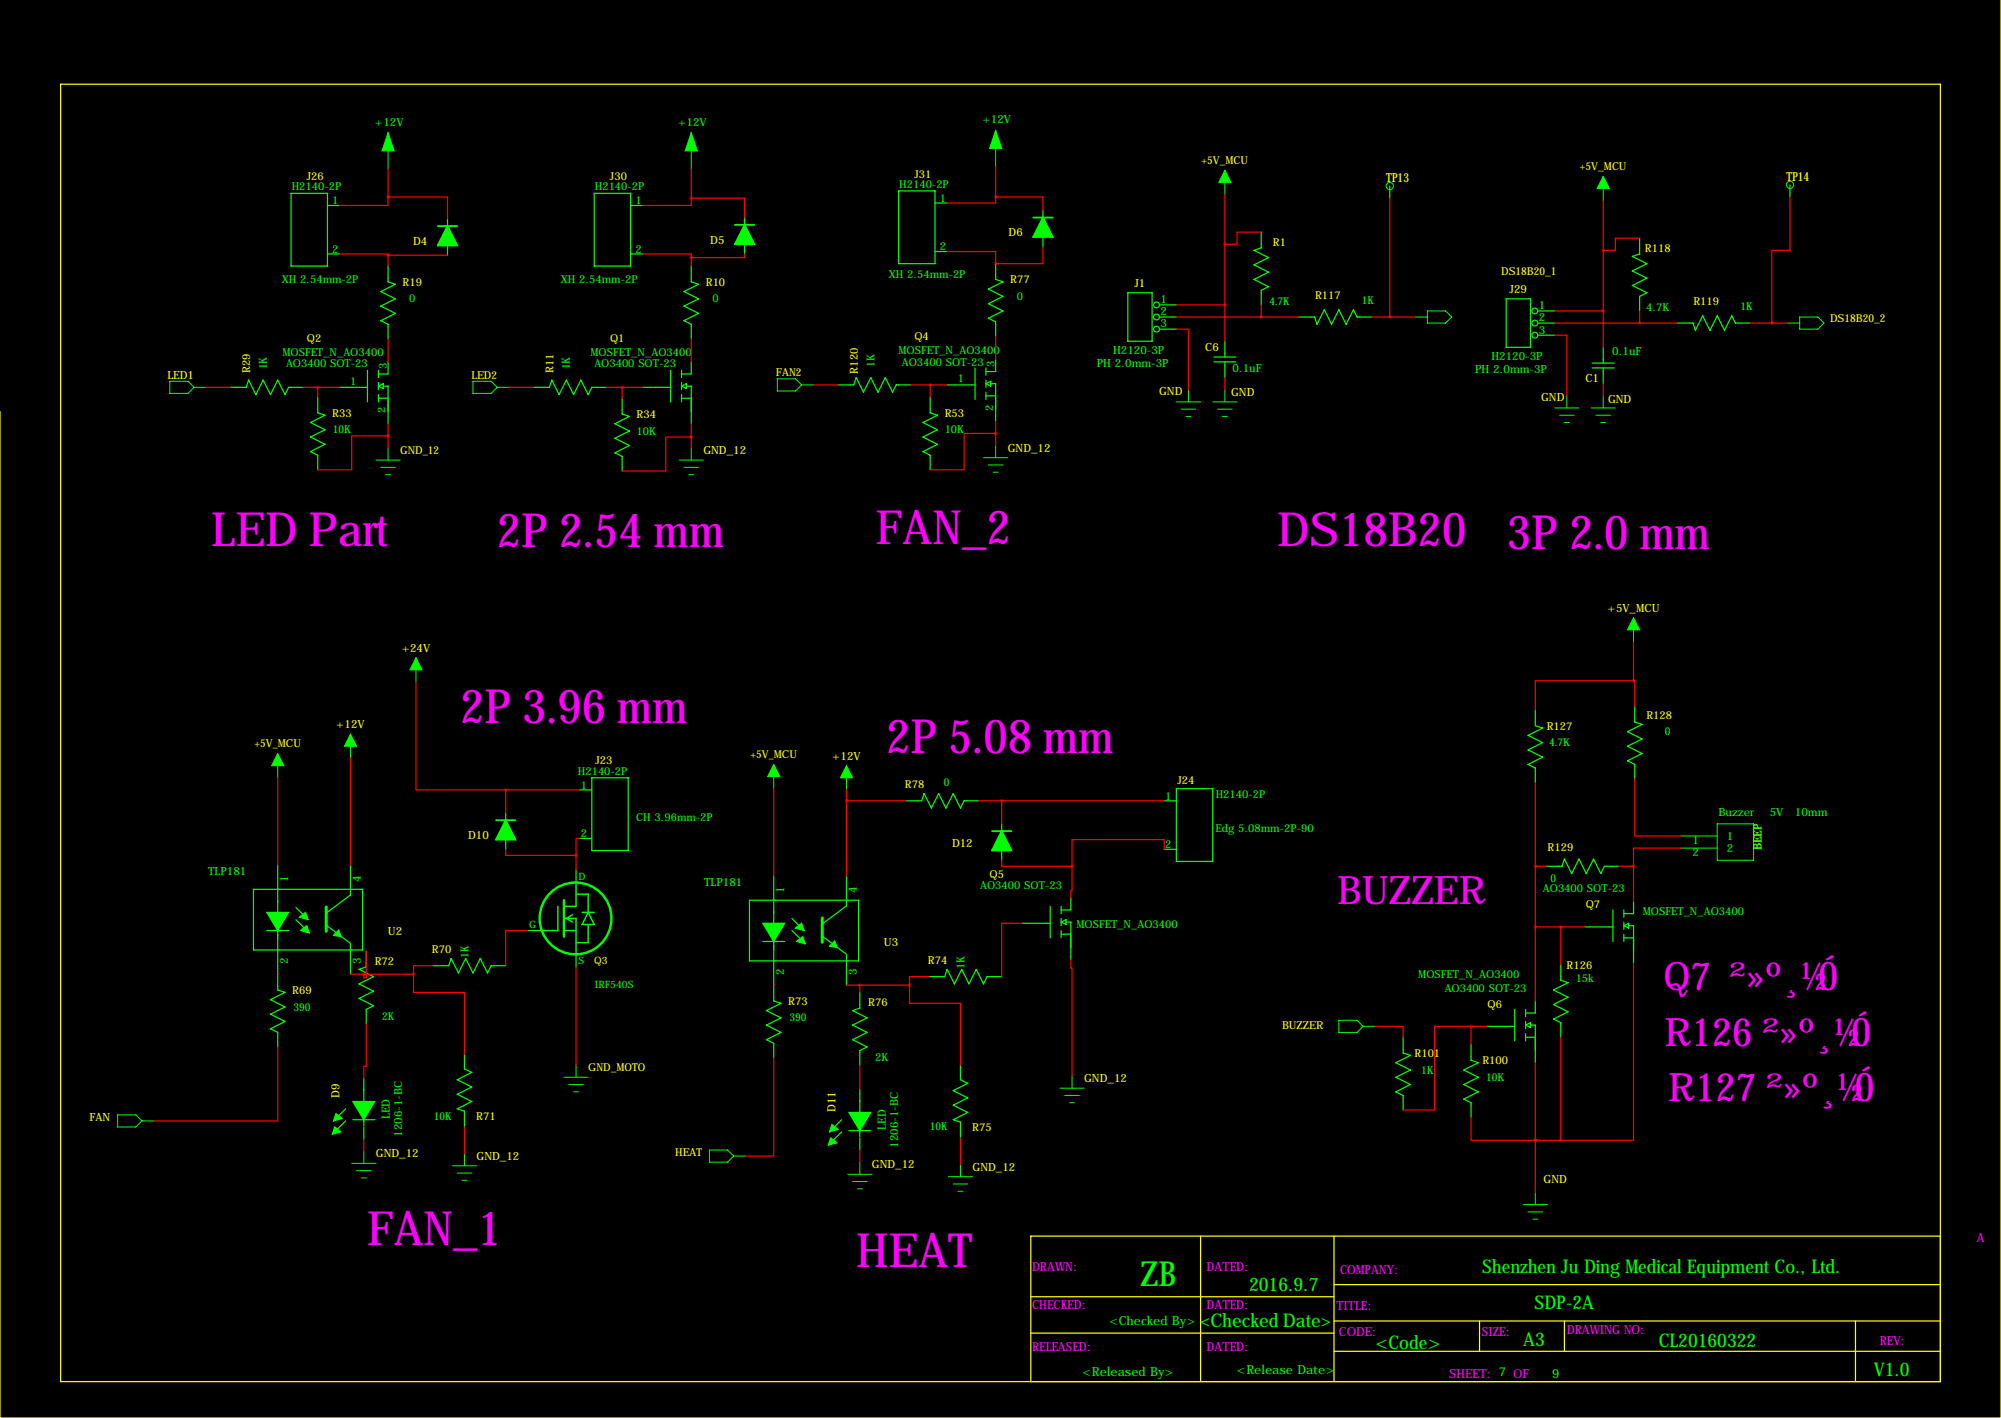
[picture p24: page 7]

Shenzhen Ju Ding Medical Equipment Co., Ltd.

# USB to Serial

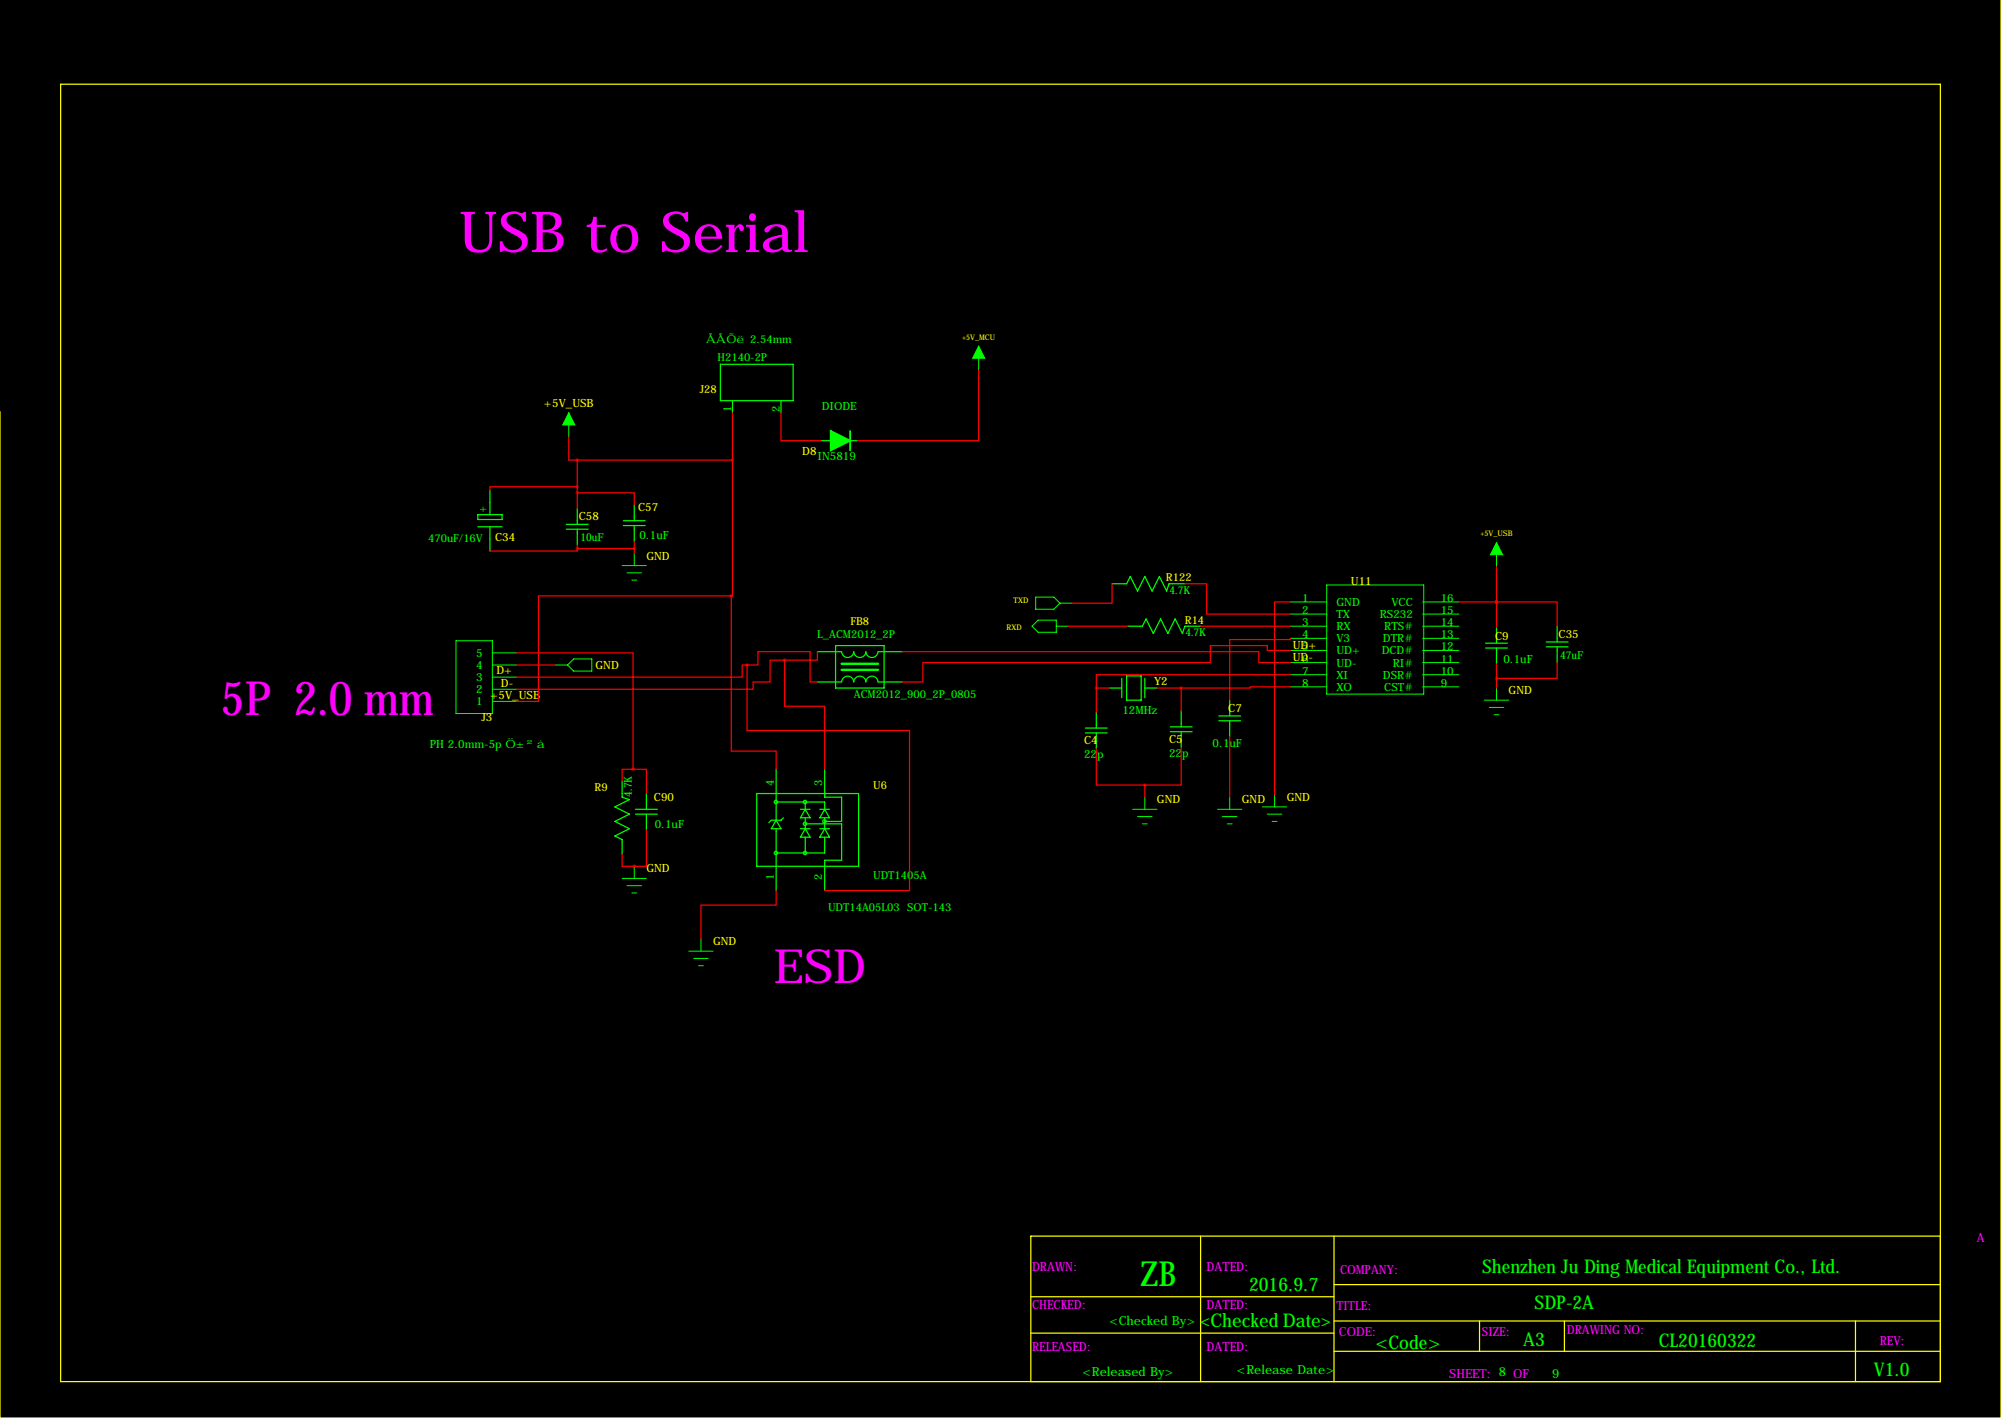
[picture p25: page 8]

D+ | GND
D-
+5V_USB

Shenzhen Ju Ding Medical Equipment Co., Ltd.

# IF 17 mA 3P 2.0 mm

# 7280 È±Ö½

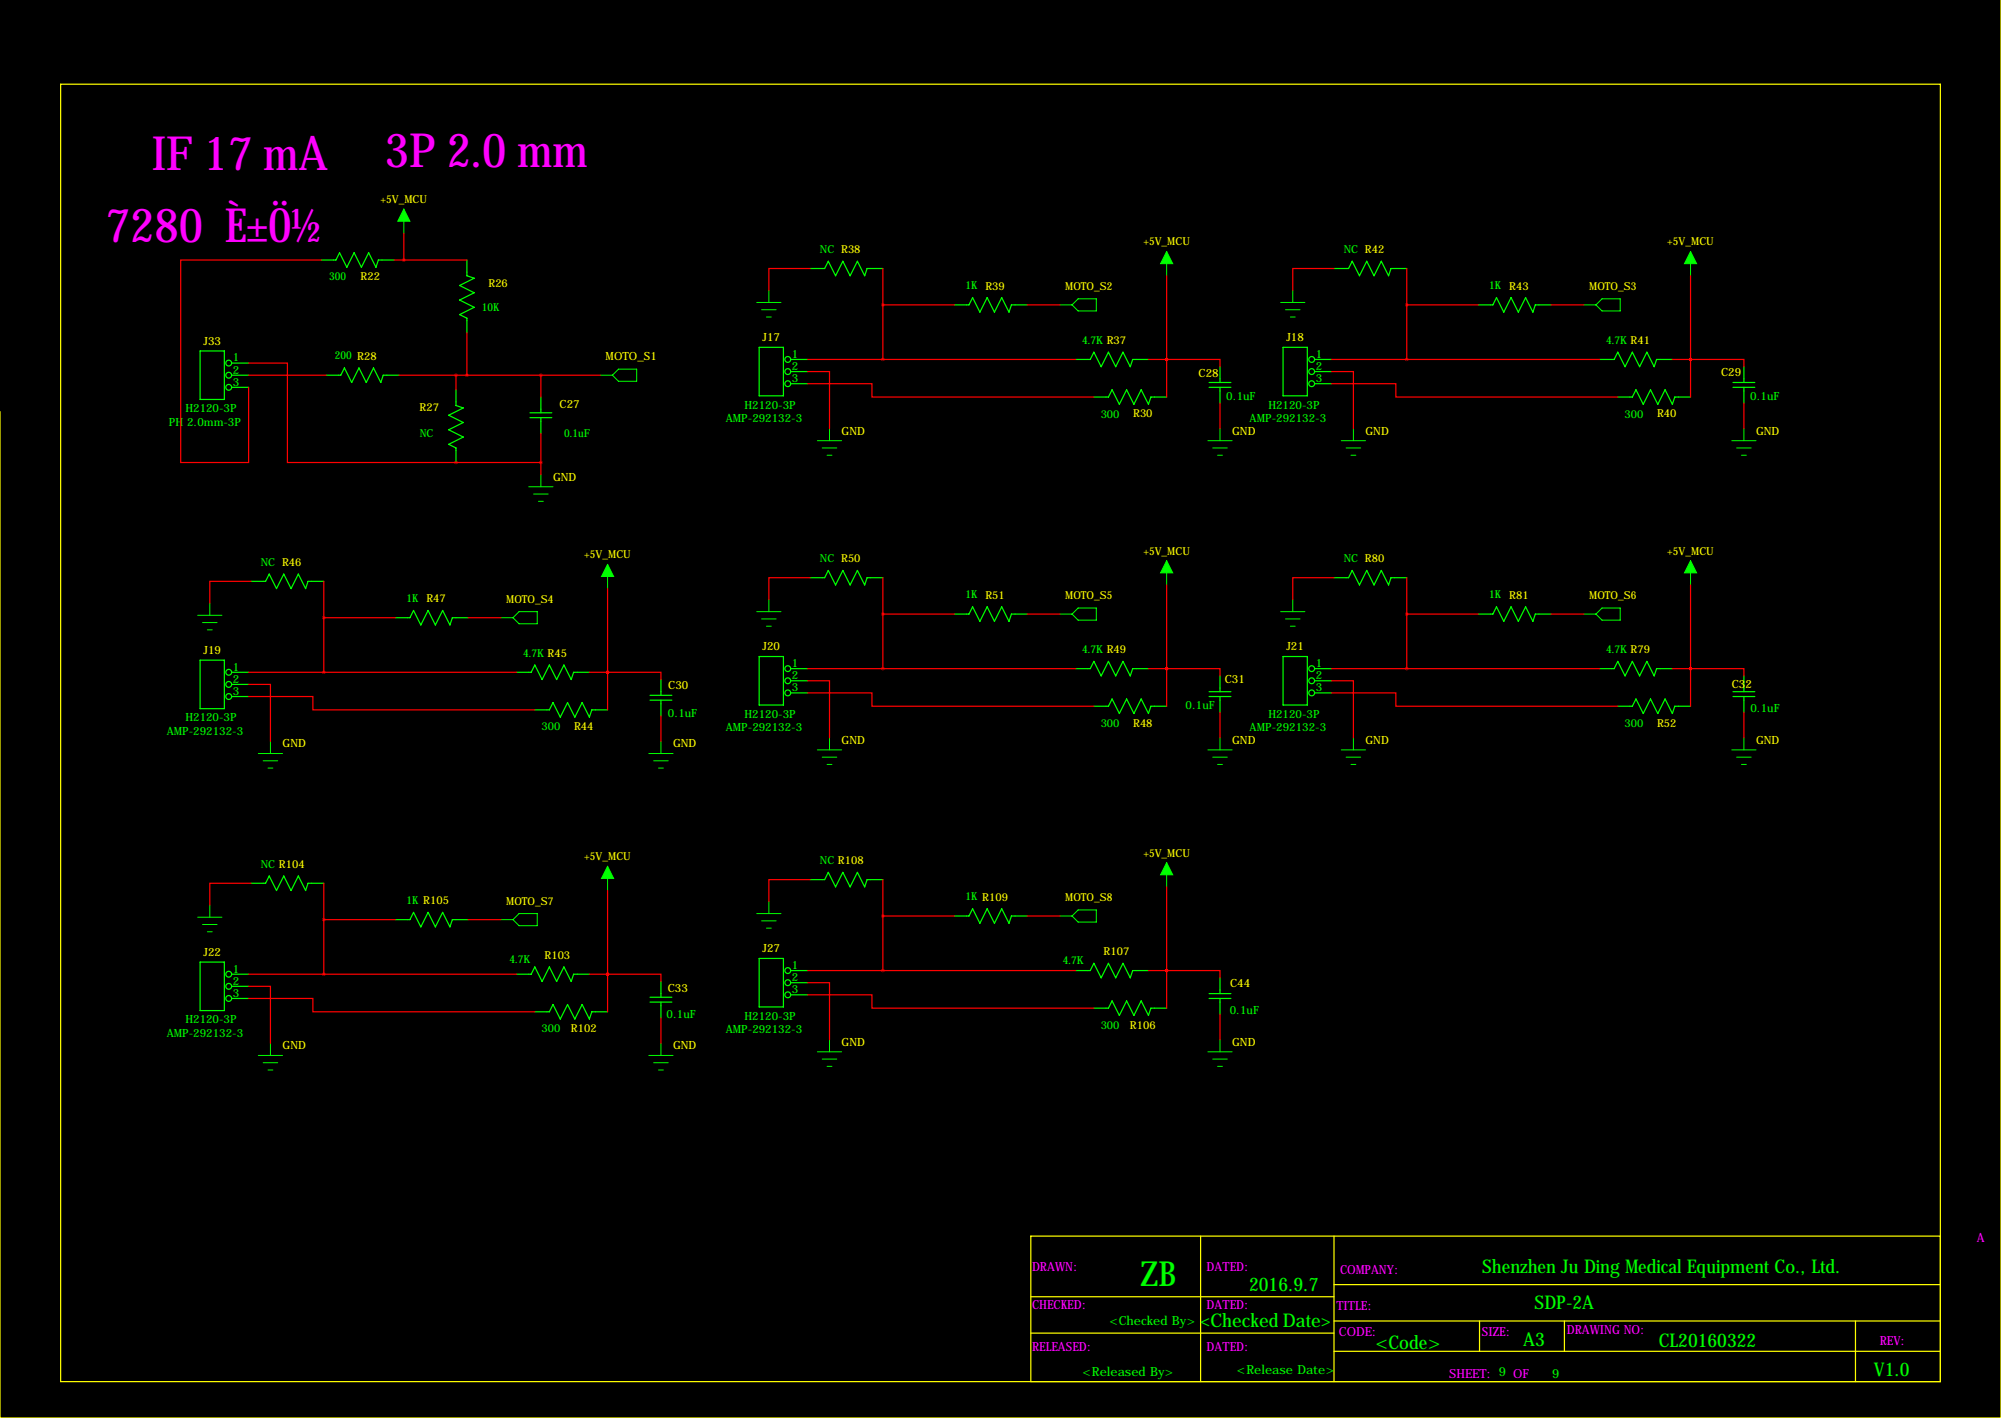
[picture p26: page 9]

Shenzhen Ju Ding Medical Equipment Co., Ltd.
