Chinglyn/SDP-2A/01 PCB菲林文件PDF档/CLR.DB01.A_菲林.pdf

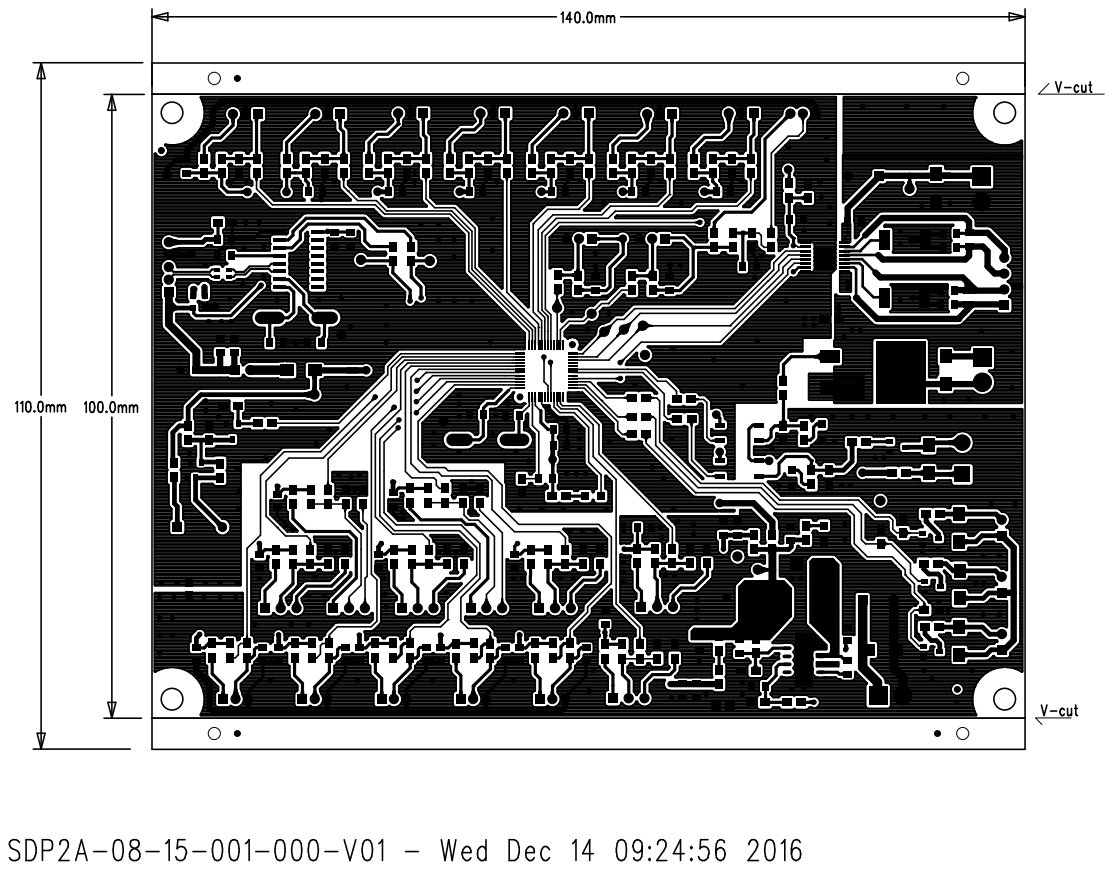
[picture p27: page 1]

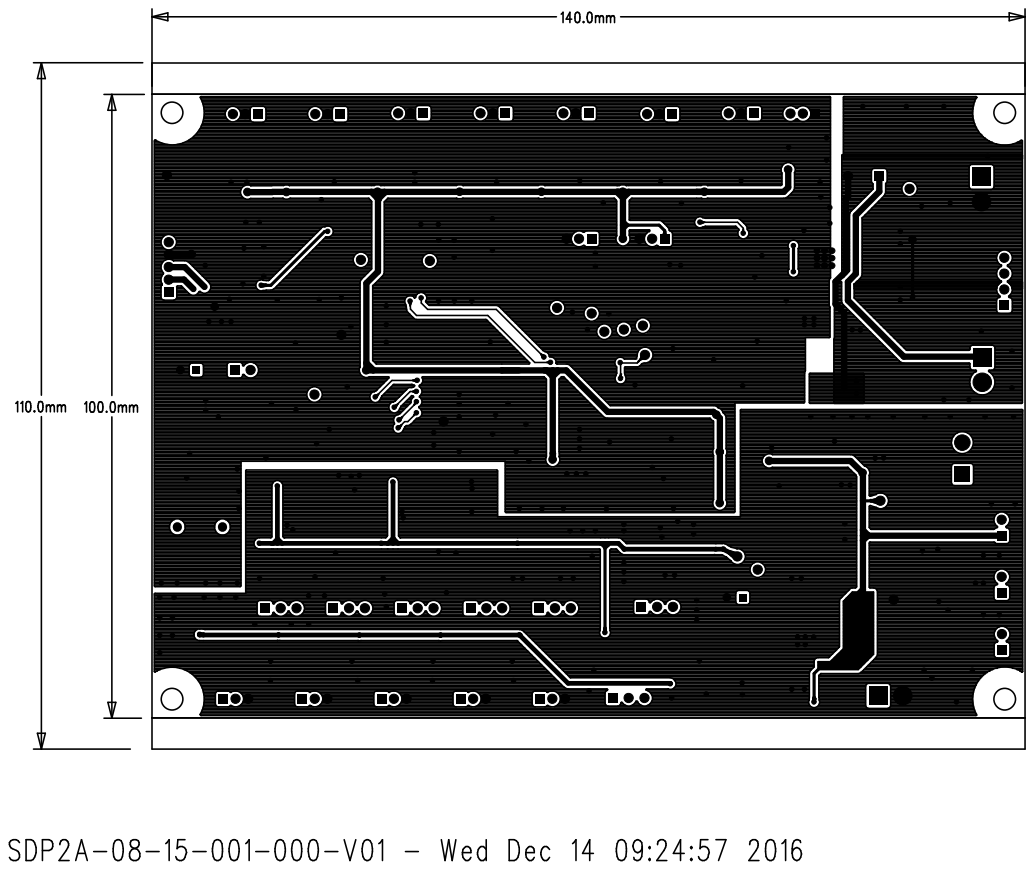
[picture p28: page 2]

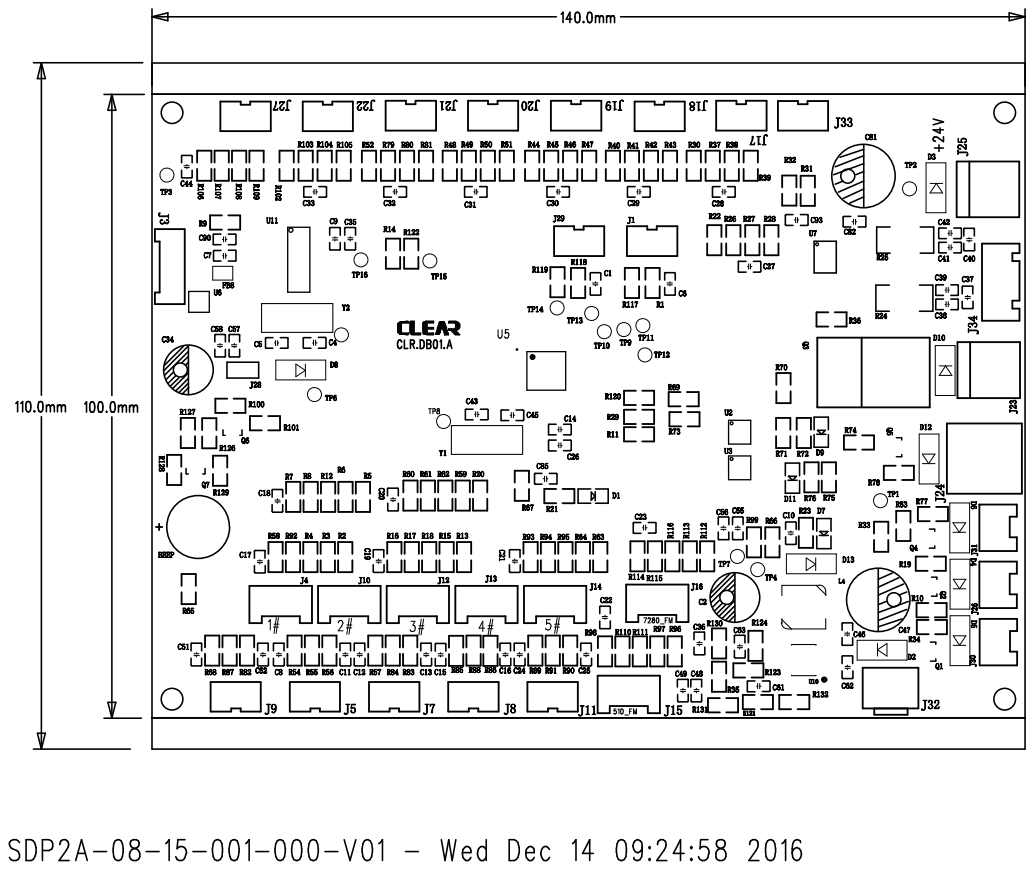
[picture p29: page 3]

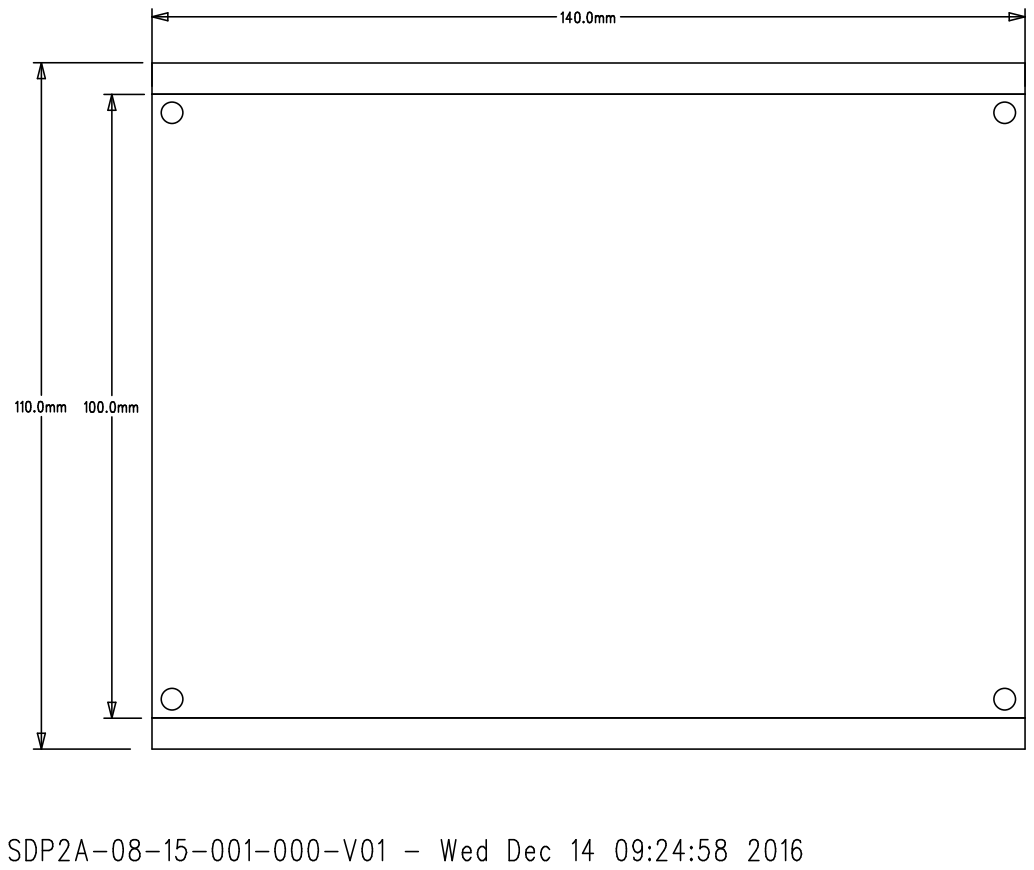
[picture p30: page 4]

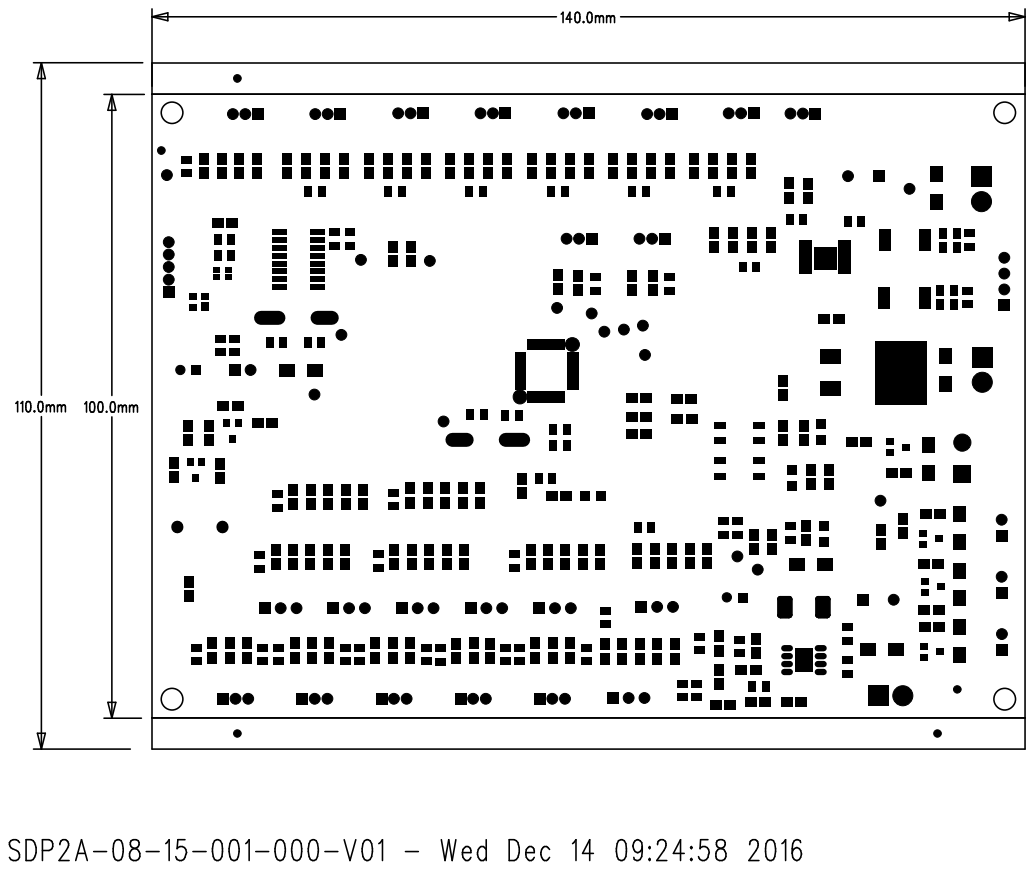
[picture p31: page 5]

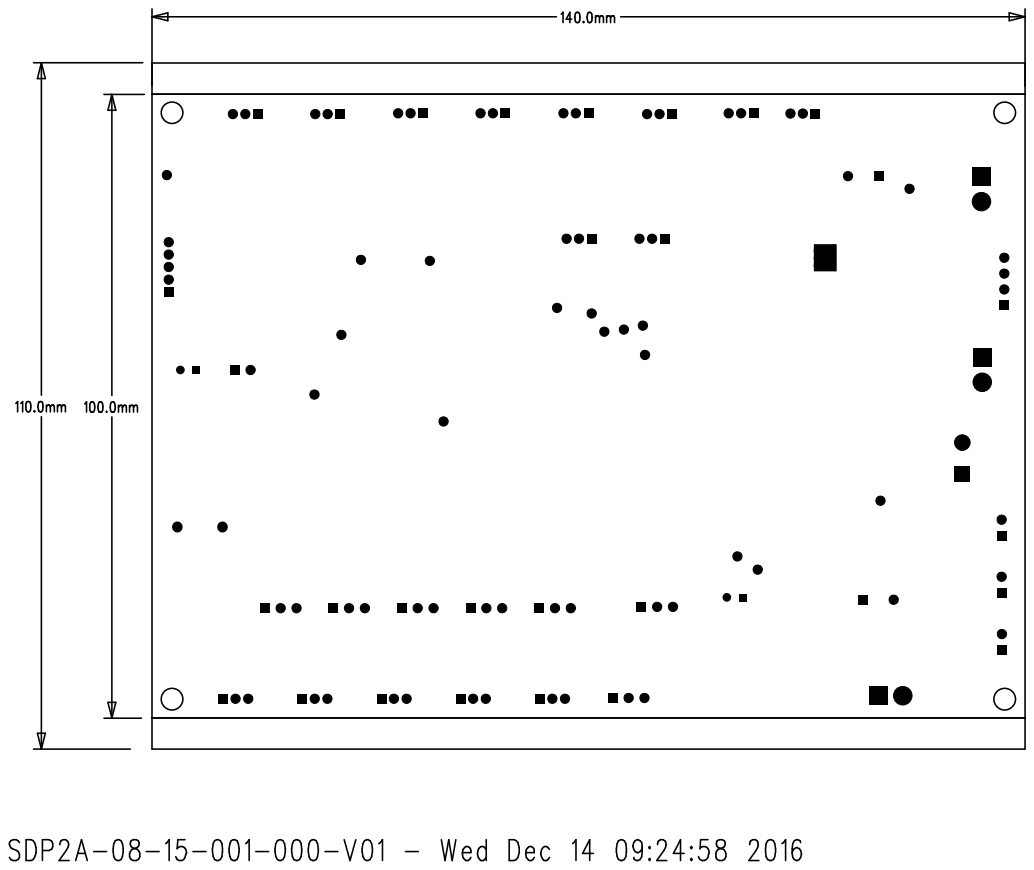
[picture p32: page 6]

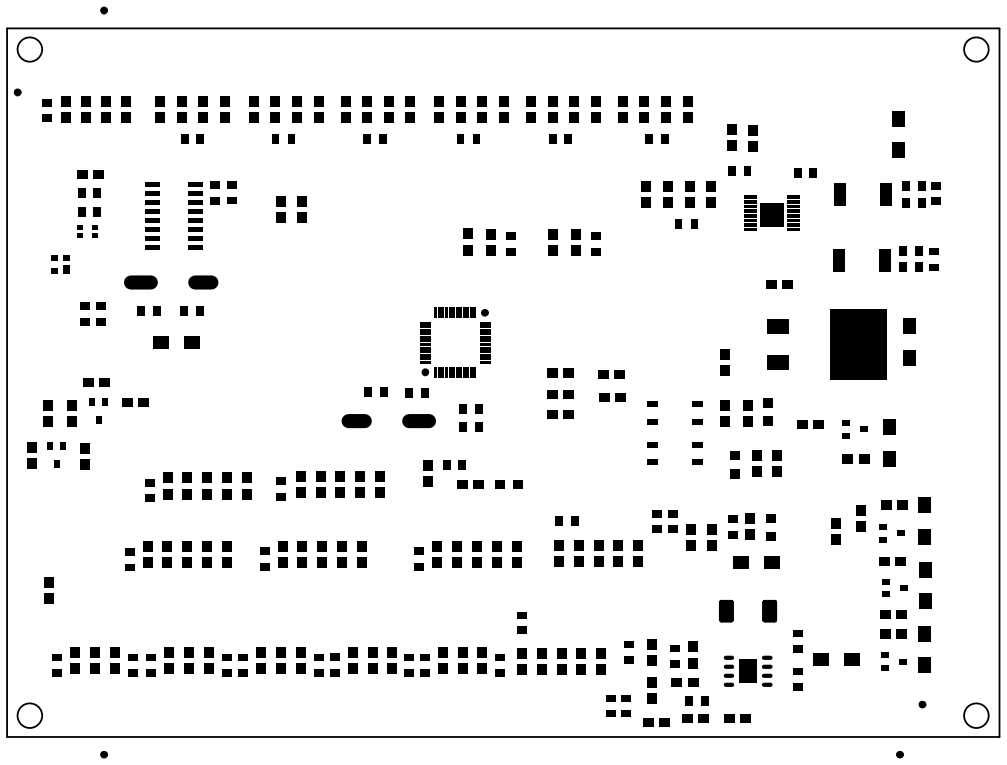
[picture p33: figure]

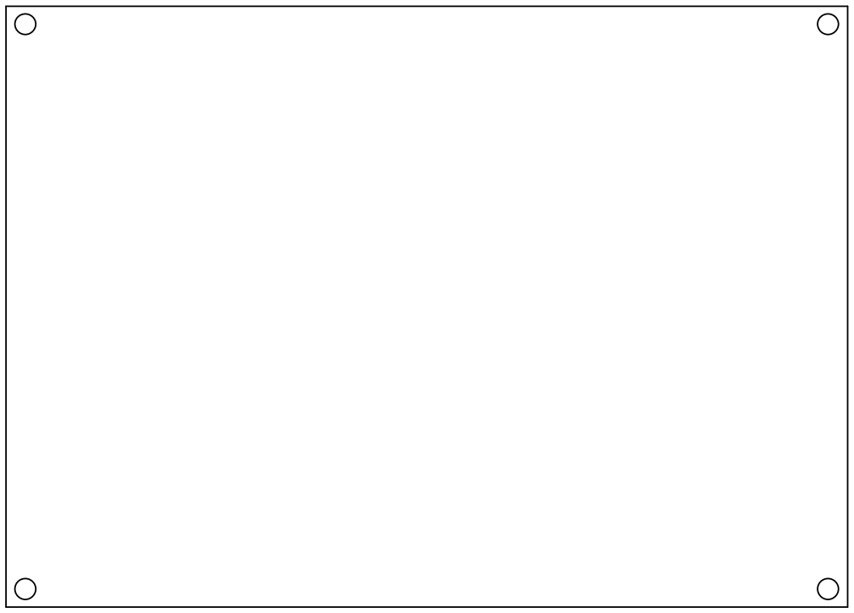
[picture p34: figure]
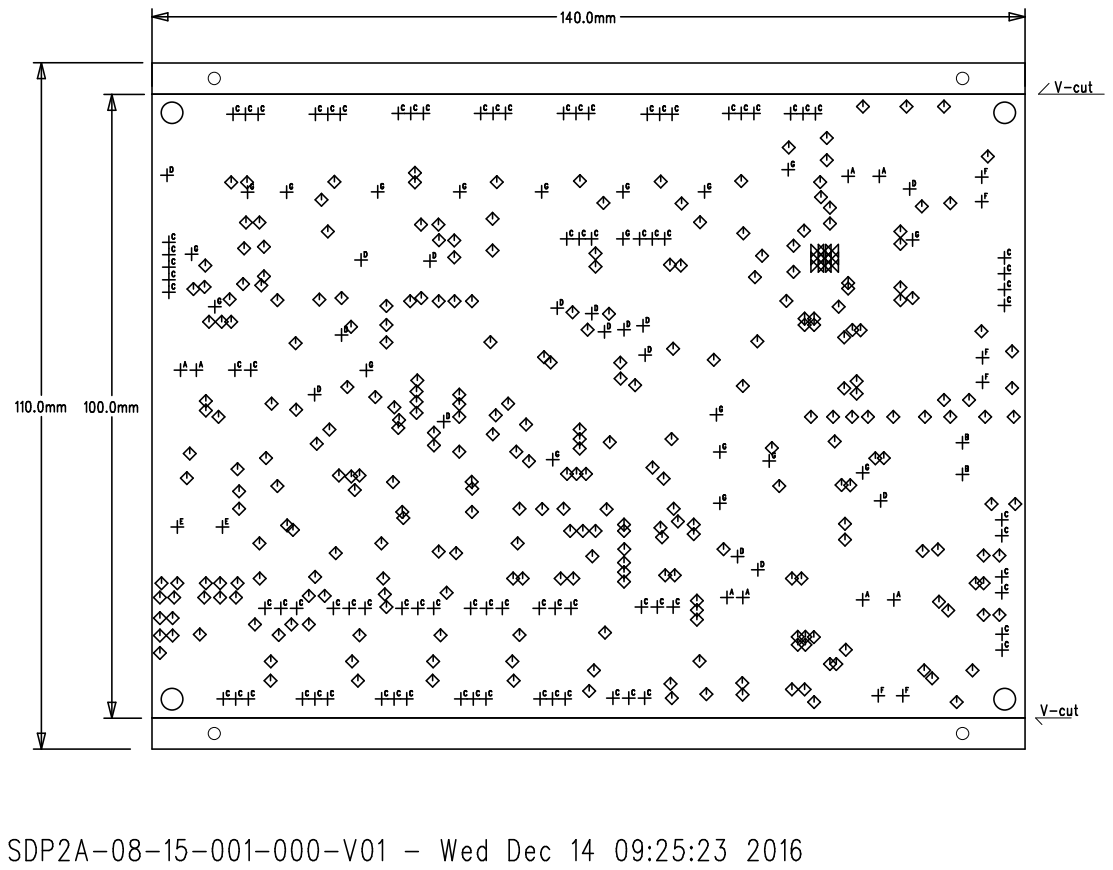
[picture p35: page 9]

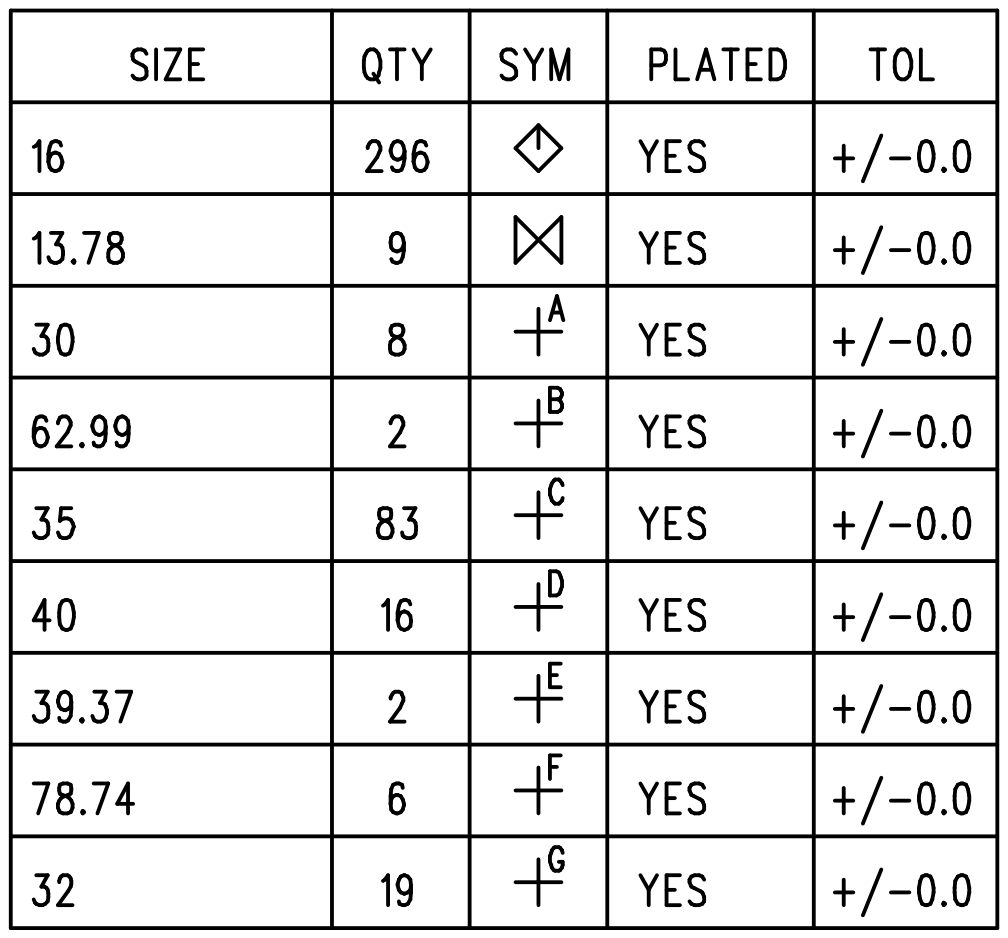
[picture p36: page 11]
