Chinglyn/SDP-2A/(list of files, drawings)

Other design files:
13 PCB源文件/CLR.DB01.A.pcb
