Chinglyn/SDP-2A/14 源程序工程/CLR.DB01.A_SDP-2A-V1.0 源程序工程/my_type.h

/******************************************************************

MYTYPE.H  file
  
*******************************************************************/

#ifndef __MY_TYPE_H__
#define __MY_TYPE_H__

#define u8		unsigned char
#define u16		unsigned short int
#define u32		unsigned long int
#define u64		unsigned long long int
#define s8		signed char
#define s16		signed short int
#define s32		signed long int
#define s64		signed long long int

#endif

/**///////////////////////Pino Electronics////////////////////////**/
