Chinglyn/SDP-2A/14 源程序工程/CLR.DB01.A_SDP-2A-V1.0 源程序工程/time.h

/******************************************************************
UART1.H  file  
*******************************************************************/

#ifndef __TIME_H__
#define __TIME_H__

#include "unit.h"
#include "stc15w4k32s4.h"

void InitTimer0(void);
void Timer2Init(void);

#endif





/**///////////////////////Pino Electronics////////////////////////**/
