Chinglyn/SDP-2A/14 源程序工程/CLR.DB01.A_SDP-2A-V1.0 源程序工程/uart1.h

/******************************************************************
UART1.H  file  
*******************************************************************/

#ifndef __UART1_H__
#define __UART1_H__

#include "unit.h"
void InitUart1(void);
void uart1sendonebyte(u8 x);
void uart1senddata(u8 *p,u8 num);

#endif





/**///////////////////////Pino Electronics////////////////////////**/
